Verdefluox/Eurocard_LNA/LNA_v1.pdf

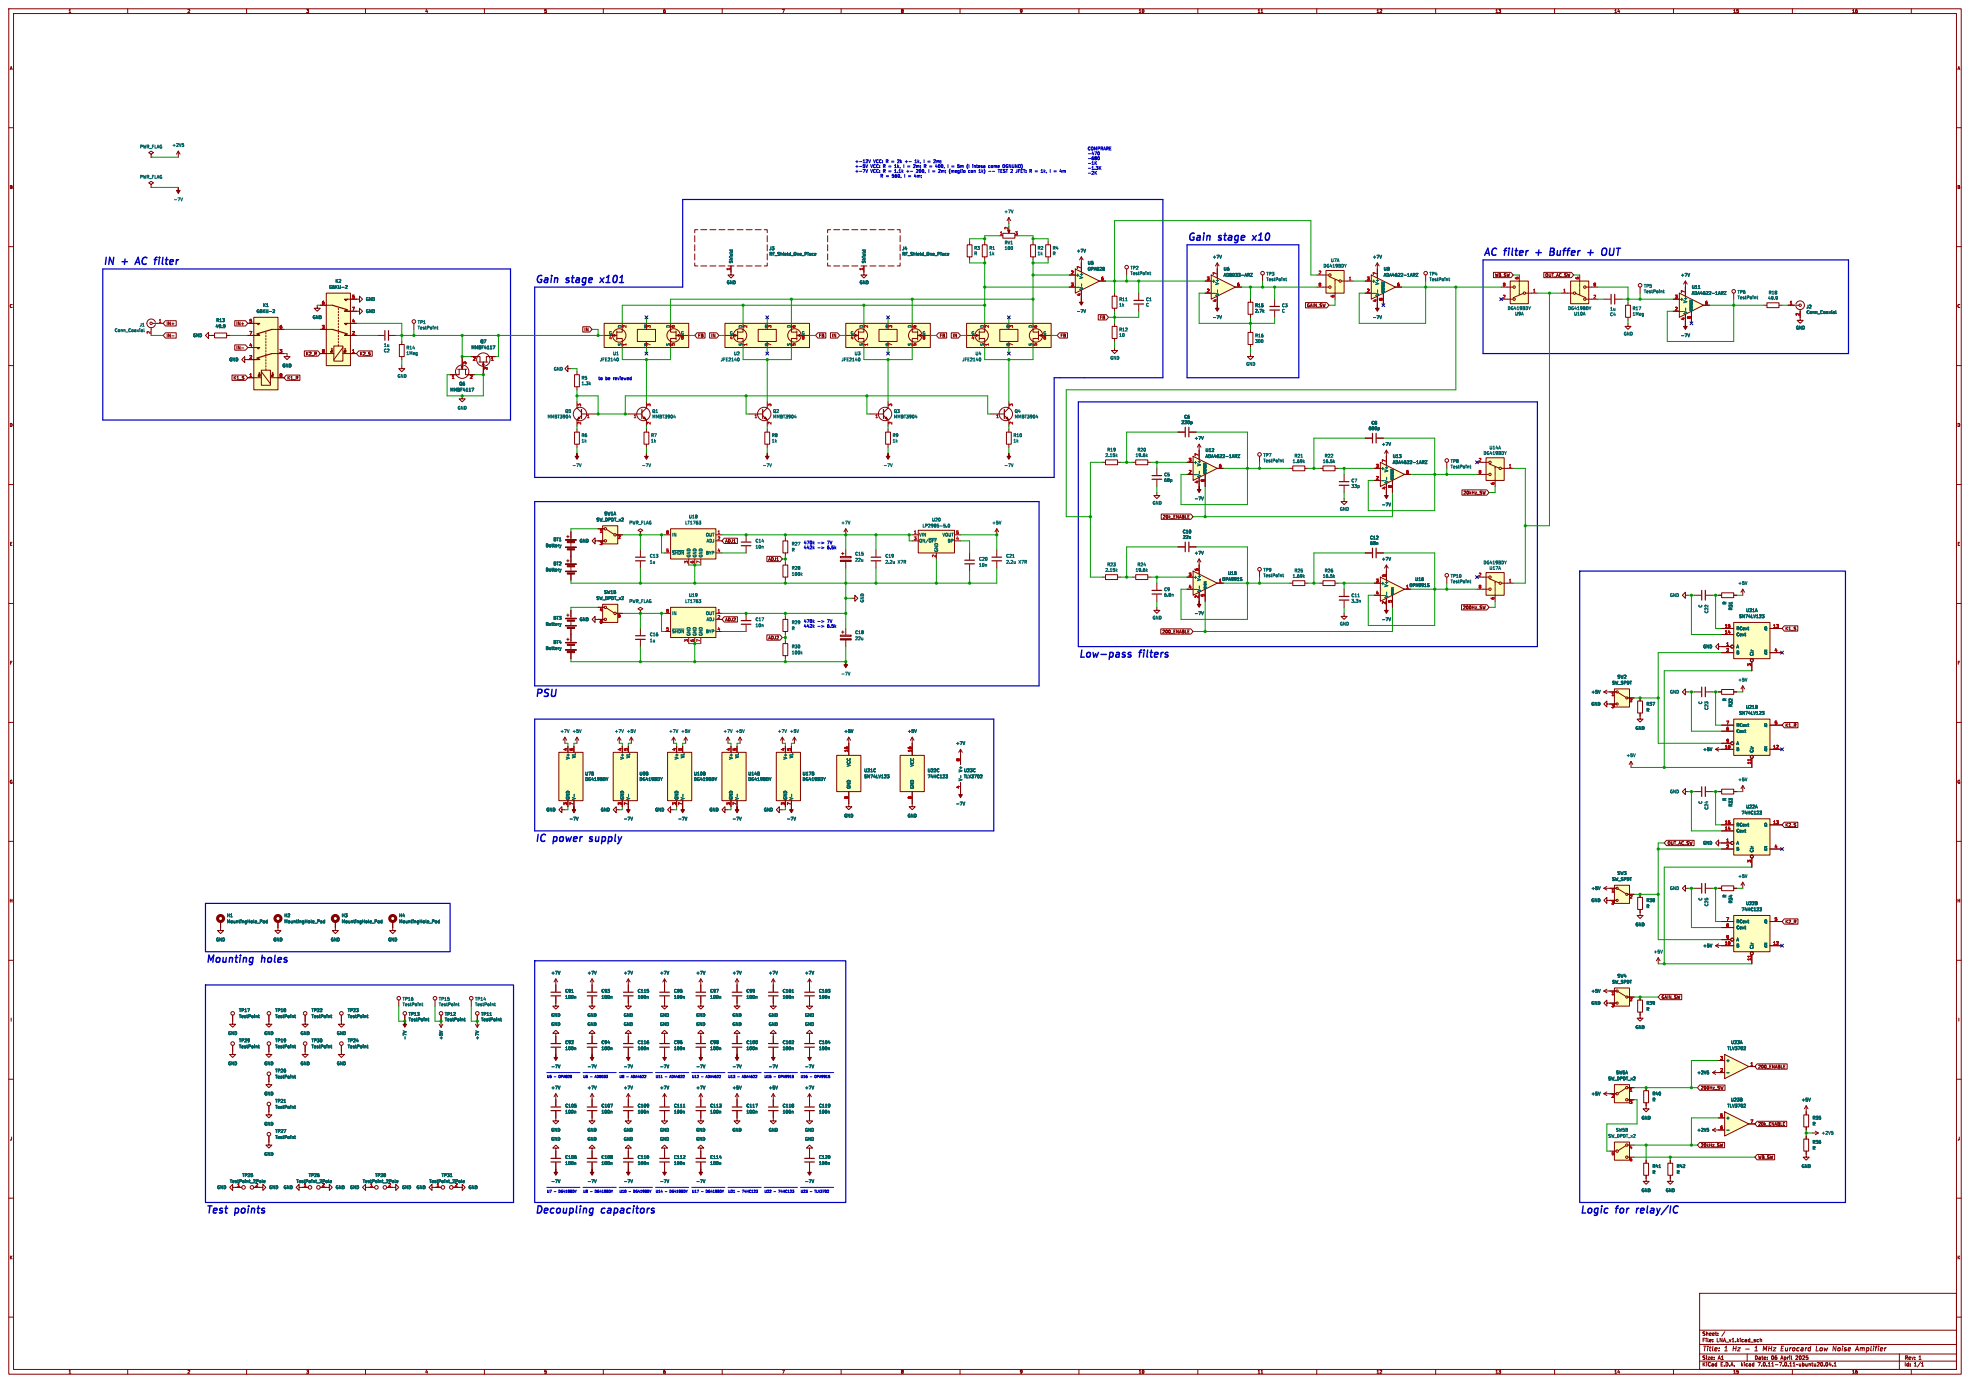
[picture p1: page 1]

AC filter + Buffer + OUT

Logic for relay/IC

Id: 1/1 Title: 1 Hz - 1 MHz Eurocard Low Noise Amplifier File: LNA_v1.kicad_sch Sheet: /
