Verdefluox/Eurocard_LNA/LNA_v1.kicad_pcb

## KiCad design LNA_v1.kicad_pcb (2025-04-08)

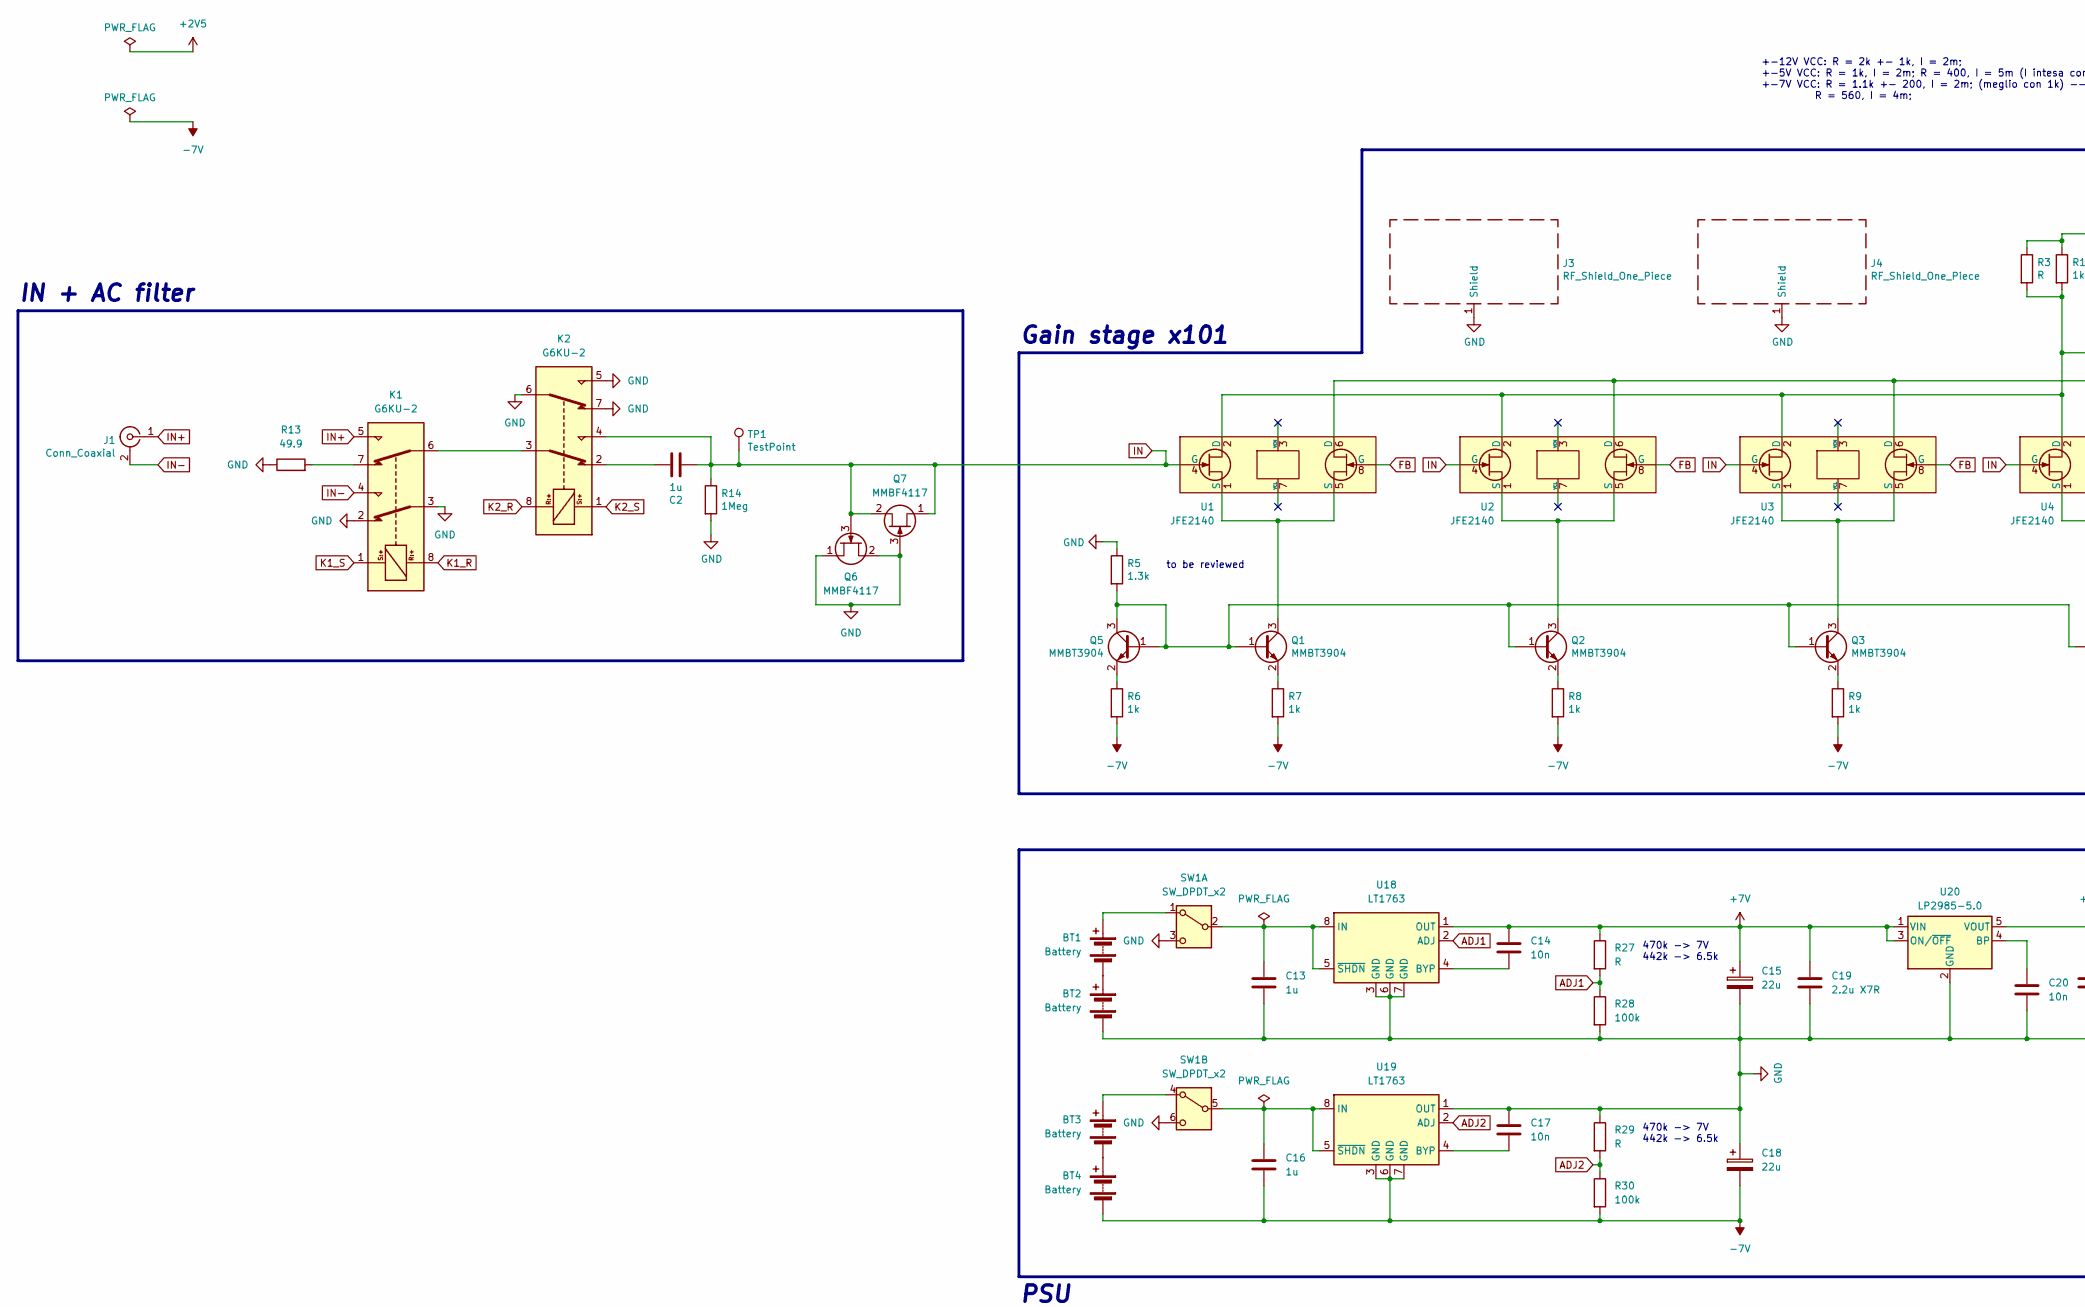
[picture p2: schematic LNA_v1.kicad_sch, 1 Hz - 1 MHz Eurocard Low Noise Amplifier, part in row 1, column 1]

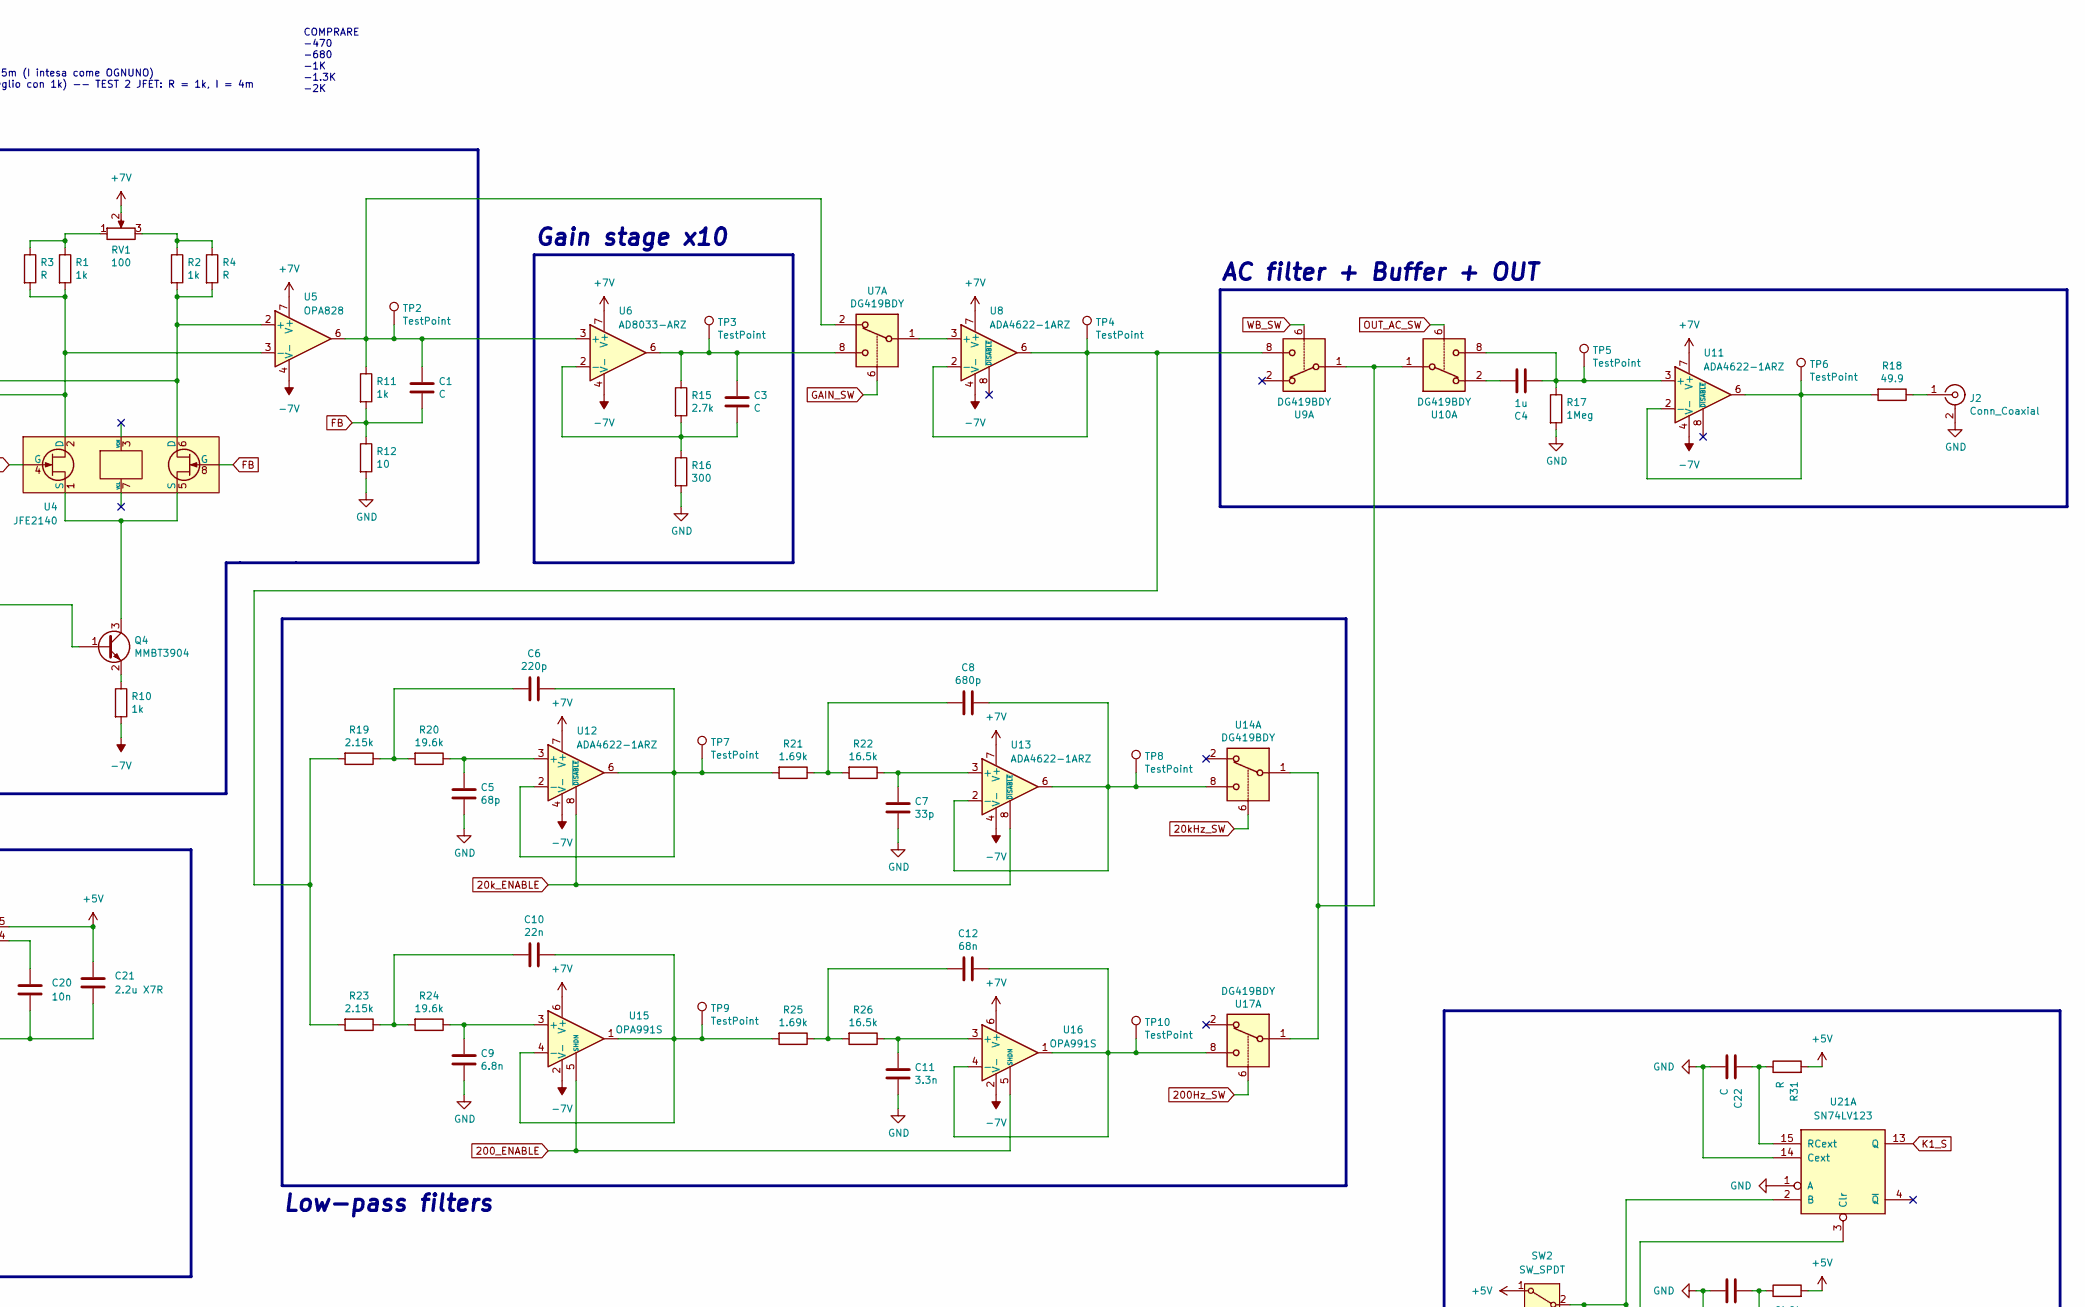
[picture p3: schematic LNA_v1.kicad_sch, 1 Hz - 1 MHz Eurocard Low Noise Amplifier, part in row 1, column 2]

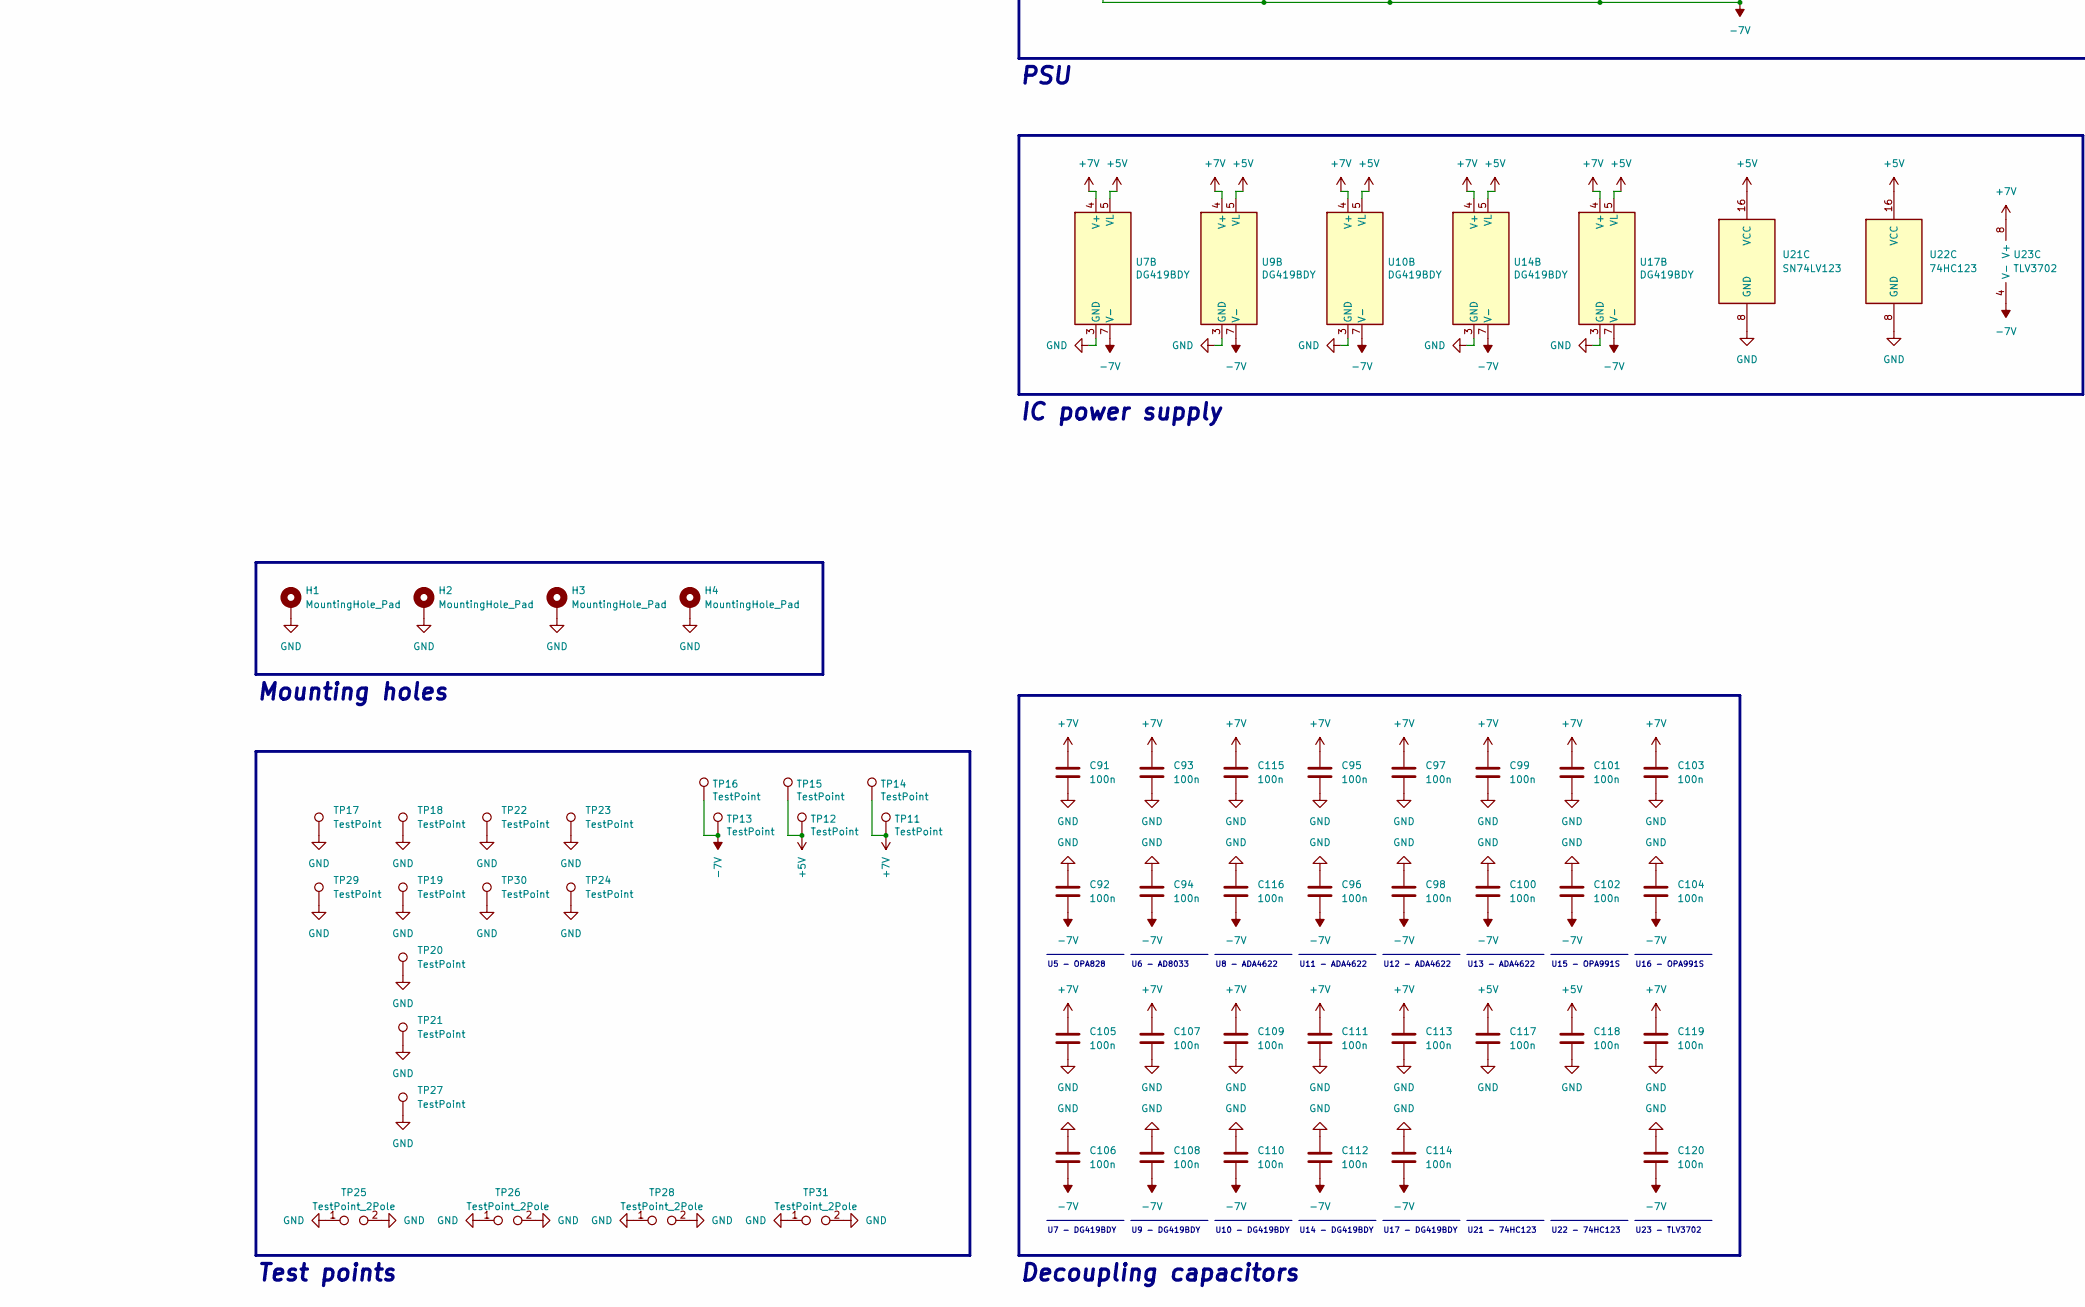
[picture p4: schematic LNA_v1.kicad_sch, 1 Hz - 1 MHz Eurocard Low Noise Amplifier, part in row 2, column 1]

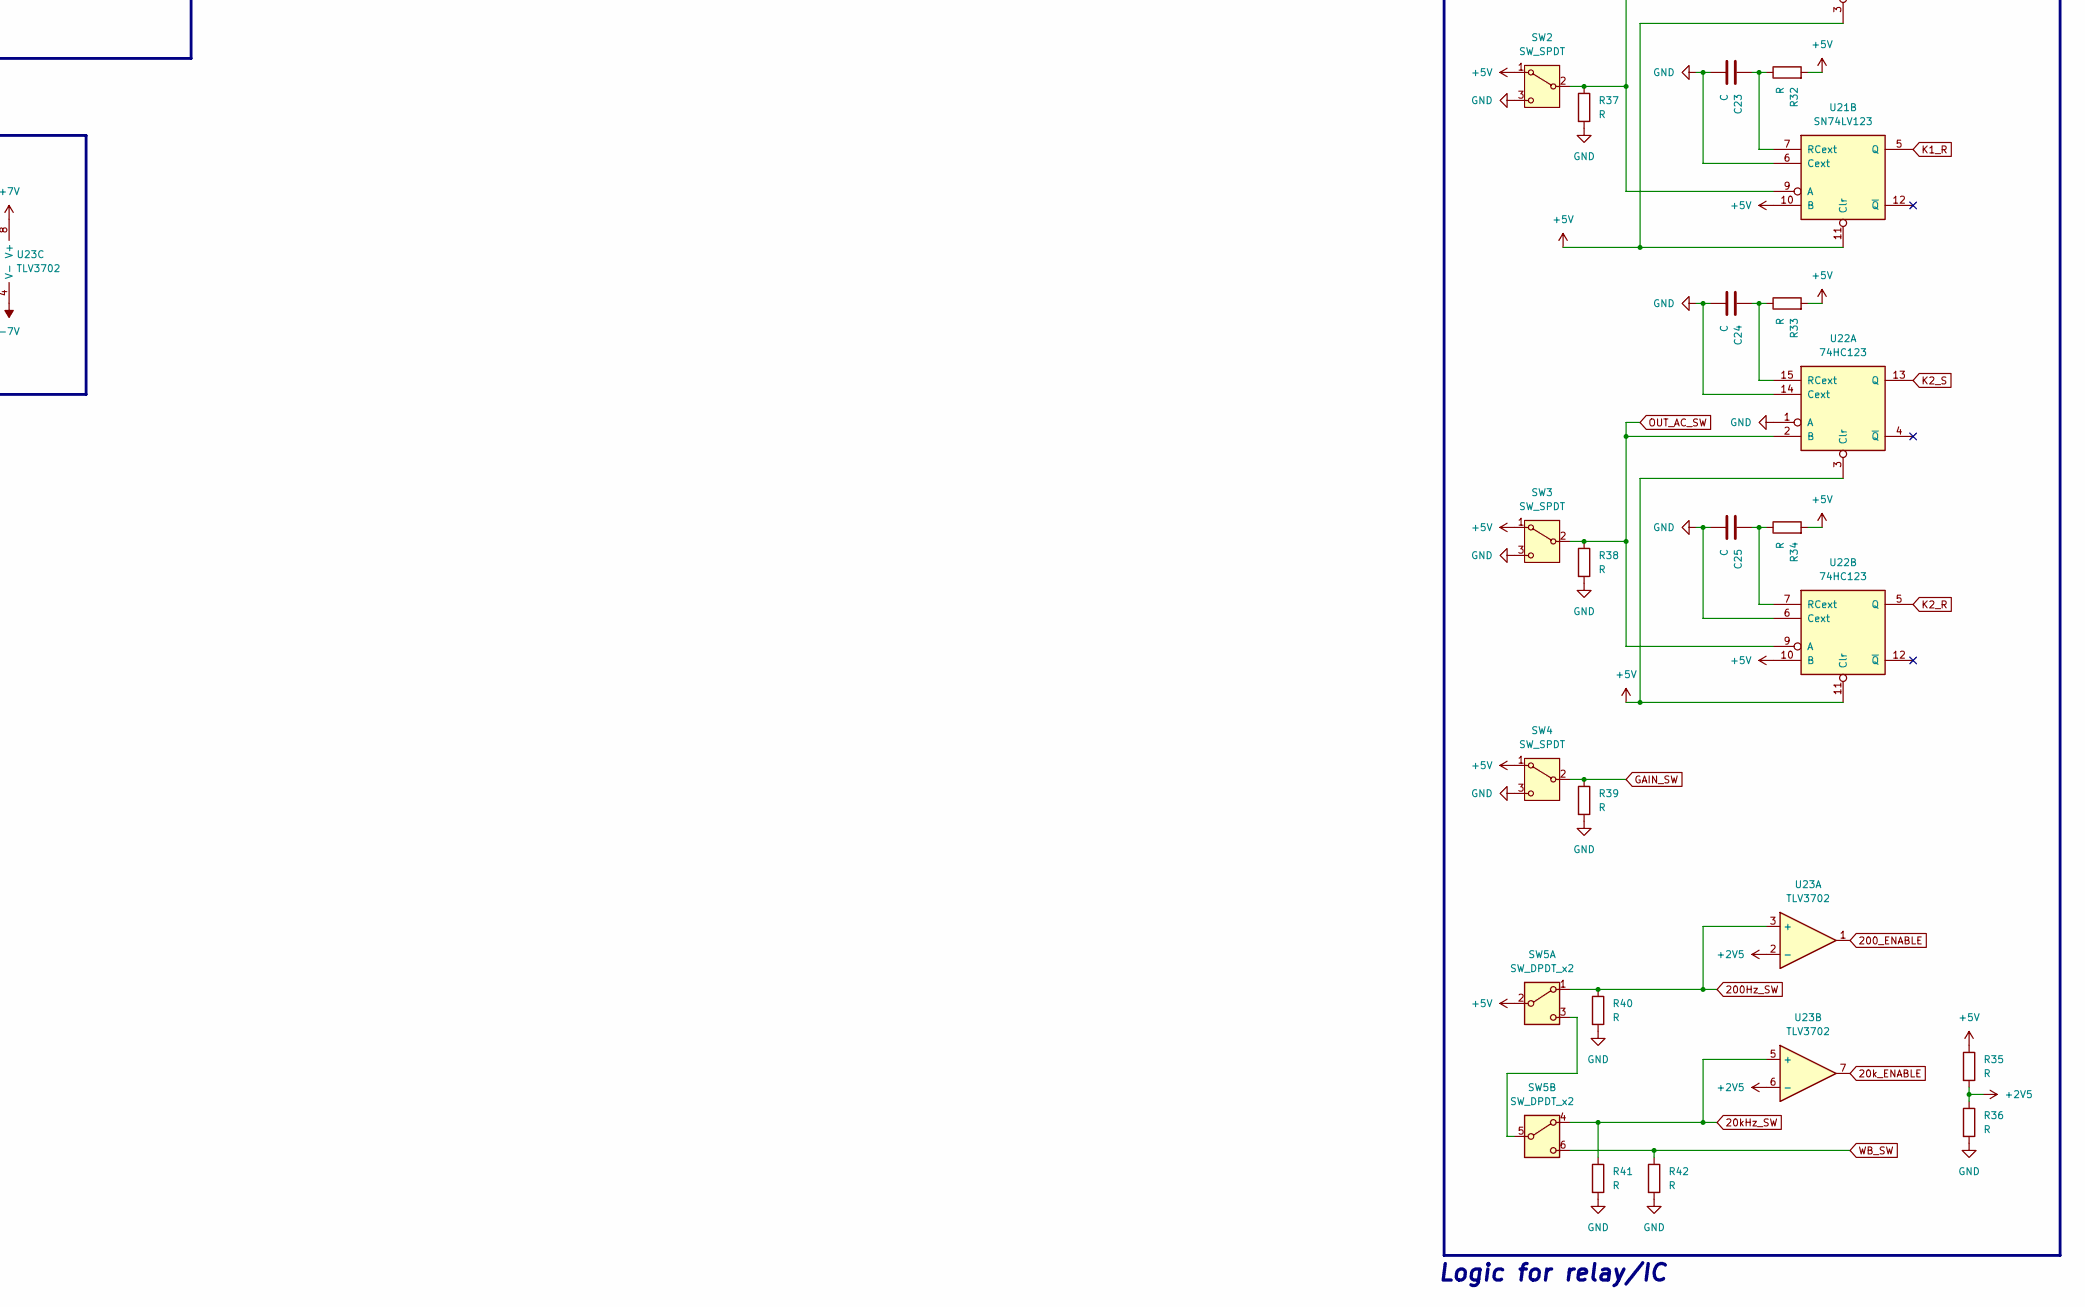
[picture p5: schematic LNA_v1.kicad_sch, 1 Hz - 1 MHz Eurocard Low Noise Amplifier, part in row 2, column 2]

Parts:
BT1, BT2, BT3, BT4: Battery; 14500_Keystone53
C1, C3: C; C_0805_2012Metric_Pad1.18x1.45mm_HandSolder
C2, C4: 1u; C_Rect_L16.5mm_W7.3mm_P15.00mm_MKT
C5: 68p; C_1206_3216Metric_Pad1.33x1.80mm_HandSolder
C6: 220p; C_1206_3216Metric_Pad1.33x1.80mm_HandSolder
C7: 33p; C_1206_3216Metric_Pad1.33x1.80mm_HandSolder
C8: 680p; C_1206_3216Metric_Pad1.33x1.80mm_HandSolder
C9: 6.8n; C_1206_3216Metric_Pad1.33x1.80mm_HandSolder
C10: 22n; C_1206_3216Metric_Pad1.33x1.80mm_HandSolder
C11: 3.3n; C_1206_3216Metric_Pad1.33x1.80mm_HandSolder
C12: 68n; C_1206_3216Metric_Pad1.33x1.80mm_HandSolder
C13, C16: 1u; C_1206_3216Metric_Pad1.33x1.80mm_HandSolder
C14, C17: 10n; C_0805_2012Metric_Pad1.18x1.45mm_HandSolder
C15, C18: 22u; CP_EIA-3528-21_Kemet-B_Pad1.50x2.35mm_HandSolder
C19, C21: 2.2u X7R; C_1206_3216Metric_Pad1.33x1.80mm_HandSolder
C20: 10n; C_1206_3216Metric_Pad1.33x1.80mm_HandSolder
C22, C23, C24, C25: C; C_1206_3216Metric_Pad1.33x1.80mm_HandSolder
C91, C92, C93, C94, C95, C96, C97, C98, C99, C100, C101, C102, C103, C104, C105, C106, C107, C108, C109, C110, C111, C112, C113, C114, C115, C116, C117, C118, C119, C120: 100n; C_1206_3216Metric_Pad1.33x1.80mm_HandSolder
H1, H2, H3, H4: MountingHole_Pad; MountingHole_2.2mm_M2_Pad_Via
J1, J2: Conn_Coaxial; BNC_Amphenol_B6252HB-NPP3G-50_Horizontal
J3, J4: RF_Shield_One_Piece; Wuerth_36103305_30x30mm
K1, K2: G6KU-2; Relay_DPDT_Omron_G6K-2F-Y
Q1, Q2, Q3, Q4, Q5: MMBT3904; SOT-23W
Q6, Q7: MMBF4117; SOT-23
R1, R2, R6, R7, R8, R9, R10, R11: 1k; R_1206_3216Metric_Pad1.30x1.75mm_HandSolder
R3, R4, R31, R32, R33, R34, R35, R36, R37, R38, R39, R40, R41, R42: R; R_1206_3216Metric_Pad1.30x1.75mm_HandSolder
R5: 1.3k; R_1206_3216Metric_Pad1.30x1.75mm_HandSolder
R12: 10; R_1206_3216Metric_Pad1.30x1.75mm_HandSolder
R13, R18: 49.9; R_1206_3216Metric_Pad1.30x1.75mm_HandSolder
R14, R17: 1Meg; R_1206_3216Metric_Pad1.30x1.75mm_HandSolder
R15: 2.7k; R_1206_3216Metric_Pad1.30x1.75mm_HandSolder
R16: 300; R_1206_3216Metric_Pad1.30x1.75mm_HandSolder
R19, R23: 2.15k; R_1206_3216Metric_Pad1.30x1.75mm_HandSolder
R20, R24: 19.6k; R_1206_3216Metric_Pad1.30x1.75mm_HandSolder
R21, R25: 1.69k; R_1206_3216Metric_Pad1.30x1.75mm_HandSolder
R22, R26: 16.5k; R_1206_3216Metric_Pad1.30x1.75mm_HandSolder
R27, R29: R; R_0805_2012Metric_Pad1.20x1.40mm_HandSolder
R28, R30: 100k; R_0805_2012Metric_Pad1.20x1.40mm_HandSolder
RV1: 100; Potentiometer_Bourns_3296W_Vertical
SW1, SW5: SW_DPDT_x2; 100DPXTXBXMXXX
SW2, SW3, SW4: SW_SPDT; 100AWSPXTXBXMXXX
TP1: TestPoint; TestPoint_Pad_D1.5mm
TP2, TP3, TP4, TP5, TP6, TP7, TP8, TP9, TP10, TP11, TP12, TP13, TP14, TP15, TP16: TestPoint; TestPoint_Pad_D1.0mm
TP17, TP18, TP19, TP20, TP21, TP22, TP23, TP24, TP27, TP29, TP30: TestPoint; TestPoint_THTPad_D1.0mm_Drill0.5mm
TP25, TP26, TP28, TP31: TestPoint_2Pole; TestPoint_2Pads_Pitch5.08mm_Drill1.3mm
U1, U2, U3, U4: JFE2140; SOIC-8_3.9x4.9mm_P1.27mm
U5: OPA828; SOIC-8_3.9x4.9mm_P1.27mm
U6: AD8033-ARZ; SOIC-8_3.9x4.9mm_P1.27mm
U7, U9, U10, U14, U17: DG419BDY; SOIC-8_3.9x4.9mm_P1.27mm
U8, U11, U12, U13: ADA4622-1ARZ; SOIC-8_3.9x4.9mm_P1.27mm
U15, U16: OPA991S; SOT-23-6
U18, U19: LT1763; SOIC-8_3.9x4.9mm_P1.27mm
U20: LP2985-5.0; SOT-23-5
U21: SN74LV123; SOIC-16_3.9x9.9mm_P1.27mm
U22: 74HC123; SOIC-16_3.9x9.9mm_P1.27mm
U23: TLV3702; SOIC-8_3.9x4.9mm_P1.27mm

Connections:
20kHz_SW: R41.1, SW5.4 (A), U14.6, U23.5 (+)
20k_ENABLE: U12.8 (~DISABLE), U13.8 (~DISABLE), U23.7
200Hz_SW: R40.1, SW5.1 (A), U17.6, U23.3 (+)
200_ENABLE: U15.5 (SHDN), U16.5 (SHDN), U23.1
+2V5: R35.2, R36.1, U23.2 (-), U23.6 (-)
+5V: C21.1, C117.1, C118.1, R31.2, R32.2, R33.2, R34.2, R35.1, SW2.1 (A), SW3.1 (A), SW4.1 (A), SW5.2 (B), TP12.1, TP15.1, U7.5 (VL), U9.5 (VL), U10.5 (VL), U14.5 (VL), U17.5 (VL), U20.5 (VOUT), U21.3 (Clr), U21.10 (B), U21.11 (Clr), U21.16 (VCC), U22.3 (Clr), U22.10 (B), U22.11 (Clr), U22.16 (VCC)
+7V: C14.1, C15.1, C19.1, C91.1, C93.1, C95.1, C97.1, C99.1, C101.1, C103.1, C105.1, C107.1, C109.1, C111.1, C113.1, C115.1, C119.1, R27.1, RV1.2, TP11.1, TP14.1, U5.7 (V+), U6.7 (V+), U7.4 (V+), U8.7 (V+), U9.4 (V+), U10.4 (V+), U11.7 (V+), U12.7 (V+), U13.7 (V+), U14.4 (V+), U15.6 (V+), U16.6 (V+), U17.4 (V+), U18.1 (OUT), U20.1 (VIN), U20.3 (ON/~OFF), U23.8 (V+)
-7V: BT4.2 (-), C16.2, C18.2, C92.2, C94.2, C96.2, C98.2, C100.2, C102.2, C104.2, C106.2, C108.2, C110.2, C112.2, C114.2, C116.2, C120.2, R6.2, R7.2, R8.2, R9.2, R10.2, R30.2, TP13.1, TP16.1, U5.4 (V-), U6.4 (V-), U7.7 (V-), U8.4 (V-), U9.7 (V-), U10.7 (V-), U11.4 (V-), U12.4 (V-), U13.4 (V-), U14.7 (V-), U15.2 (V-), U16.2 (V-), U17.7 (V-), U19.3 (GND), U19.6 (GND), U19.7 (GND), U23.4 (V-)
ADJ1: R27.2, R28.1, U18.2 (ADJ)
ADJ2: R29.2, R30.1, U19.2 (ADJ)
FB: C1.2, R11.2, R12.1, U1.8 (G), U2.8 (G), U3.8 (G), U4.8 (G)
GAIN_SW: R39.1, SW4.2 (B), U7.6
GND: BT2.2 (-), C5.1, C7.1, C9.1, C11.1, C13.2, C15.2, C17.1, C18.1, C19.2, C20.2, C21.2, C22.2, C23.2, C24.2, C25.2, C91.2, C92.1, C93.2, C94.1, C95.2, C96.1, C97.2, C98.1, C99.2, C100.1, C101.2, C102.1, C103.2, C104.1, C105.2, C106.1, C107.2, C108.1, C109.2, C110.1, C111.2, C112.1, C113.2, C114.1, C115.2, C116.1, C117.2, C118.2, C119.2, C120.1, H1.1, H2.1, H3.1, H4.1, J2.2 (Ext), J3.1 (Shield), J4.1 (Shield), K1.2, K1.3, K2.5, K2.6, K2.7, Q6.1 (S), Q6.2 (D), Q7.3 (G), R5.1, R12.2, R13.1, R14.2, R16.2, R17.2, R28.2, R29.1, R36.2, R37.2, R38.2, R39.2, R40.2, R41.2, R42.2, SW1.3 (C), SW1.6 (C), SW2.3 (C), SW3.3 (C), SW4.3 (C), TP17.1, TP18.1, TP19.1, TP20.1, TP21.1, TP22.1, TP23.1, TP24.1, TP25.1, TP25.2, TP26.1, TP26.2, TP27.1, TP28.1, TP28.2, TP29.1, TP30.1, TP31.1, TP31.2, U7.3 (GND), U9.3 (GND), U10.3 (GND), U14.3 (GND), U17.3 (GND), U18.3 (GND), U18.6 (GND), U18.7 (GND), U19.1 (OUT), U20.2 (GND), U21.1 (A), U21.6 (Cext), U21.8 (GND), U21.14 (Cext), U22.1 (A), U22.6 (Cext), U22.8 (GND), U22.14 (Cext)
IN: C2.1, K2.4, Q6.3 (G), Q7.1 (S), Q7.2 (D), R14.1, TP1.1, U1.4 (G), U2.4 (G), U3.4 (G), U4.4 (G)
IN+: J1.1 (In), K1.5
IN-: J1.2 (Ext), K1.4
K1_R: K1.8, U21.5 (Q)
K1_S: K1.1, U21.13 (Q)
K2_R: K2.8, U22.5 (Q)
K2_S: K2.1, U22.13 (Q)
unnamed: BT1.1 (+), SW1.1 (A)
unnamed: BT1.2 (-), BT2.1 (+)
unnamed: BT3.1 (+), SW1.4 (A)
unnamed: BT3.2 (-), BT4.1 (+)
unnamed: C2.2, K2.2
unnamed: C3.1, R15.1, TP3.1, U6.6, U7.8
unnamed: C4.2, U10.2
unnamed: C6.2, R19.1, R20.2
unnamed: C8.2, R21.1, R22.2
unnamed: C10.2, R23.1, R24.2
unnamed: C12.2, R25.1, R26.2
unnamed: J2.1 (In), R18.1
unnamed: K1.6, K2.3
unnamed: K1.7, R13.2
unnamed: Q1.1 (B), Q2.1 (B), Q3.1 (B), Q4.1 (B), Q5.1 (B), Q5.3 (C), R5.2
unnamed: Q1.3 (C), U1.1 (S), U1.5 (S)
unnamed: Q1.2 (E), R7.1
unnamed: Q2.3 (C), U2.1 (S), U2.5 (S)
unnamed: Q2.2 (E), R8.1
unnamed: Q3.3 (C), U3.1 (S), U3.5 (S)
unnamed: Q3.2 (E), R9.1
unnamed: Q4.3 (C), U4.1 (S), U4.5 (S)
unnamed: Q4.2 (E), R10.1
unnamed: Q5.2 (E), R6.1
unnamed: R1.1, R3.1, RV1.1
unnamed: R2.1, R4.1, RV1.3
unnamed: C13.1, SW1.2 (B), U18.5 (~SHDN), U18.8 (IN)
unnamed: C16.1, SW1.5 (B), U19.5 (~SHDN), U19.8 (IN)
unnamed: R37.1, SW2.2 (B), U21.2 (B), U21.9 (A)
unnamed: SW5.3 (C), SW5.5 (B)
unnamed: R2.2, R4.2, U1.6 (D), U2.6 (D), U3.6 (D), U4.6 (D), U5.2 (+)
unnamed: R1.2, R3.2, U1.2 (D), U2.2 (D), U3.2 (D), U4.2 (D), U5.3 (-)
unnamed: C1.1, R11.1, TP2.1, U5.6, U6.3 (+), U7.2
unnamed: C3.2, R15.2, R16.1, U6.2 (-)
unnamed: U7.1, U8.3 (+)
unnamed: R19.2, R23.2, TP4.1, U8.2 (-), U8.6, U9.8
unnamed: U9.1, U10.1, U14.1, U17.1
unnamed: C4.1, R17.1, TP5.1, U10.8, U11.3 (+)
unnamed: R18.2, TP6.1, U11.2 (-), U11.6
unnamed: C5.2, R20.1, U12.3 (+)
unnamed: C6.1, R21.2, TP7.1, U12.2 (-), U12.6
unnamed: C7.2, R22.1, U13.3 (+)
unnamed: C8.1, TP8.1, U13.2 (-), U13.6, U14.8
unnamed: C9.2, R24.1, U15.3 (+)
unnamed: C10.1, R25.2, TP9.1, U15.1, U15.4 (-)
unnamed: C11.2, R26.1, U16.3 (+)
unnamed: C12.1, TP10.1, U16.1, U16.4 (-), U17.8
unnamed: C14.2, U18.4 (BYP)
unnamed: C17.2, U19.4 (BYP)
unnamed: C20.1, U20.4 (BP)
unnamed: C22.1, R31.1, U21.15 (RCext)
unnamed: C23.1, R32.1, U21.7 (RCext)
unnamed: C24.1, R33.1, U22.15 (RCext)
unnamed: C25.1, R34.1, U22.7 (RCext)
OUT_AC_SW: R38.1, SW3.2 (B), U10.6, U22.2 (B), U22.9 (A)
WB_SW: R42.1, SW5.6 (C), U9.6

Notes on the sheet:
U17 - DG419BDY
U21 - 74HC123
Logic for relay/IC
+-12V VCC: R = 2k +- 1k, I = 2m; +-5V VCC: R = 1k, I = 2m; R = 400, I = 5m (I intesa come OGNUNO) +-7V VCC: R = 1.1k +- 200, I = 2m; (meglio con 1k) -- TEST 2 JFET: R = 1k, I = 4m R = 560, I = 4m;
470k -> 7V 442k -> 6.5k
IN + AC filter
U6 - AD8033
U23 - TLV3702
Decoupling capacitors
U13 - ADA4622
U7 - DG419BDY
to be reviewed
U8 - ADA4622
U14 - DG419BDY
U16 - OPA991S
IC power supply
PSU
U5 - OPA828
Gain stage x101
U12 - ADA4622
AC filter + Buffer + OUT
Gain stage x10
U10 - DG419BDY
U15 - OPA991S
Low-pass filters
U22 - 74HC123
U9 - DG419BDY
COMPRARE -470 -680 -1K -1.3K -2K
Test points
Mounting holes
U11 - ADA4622

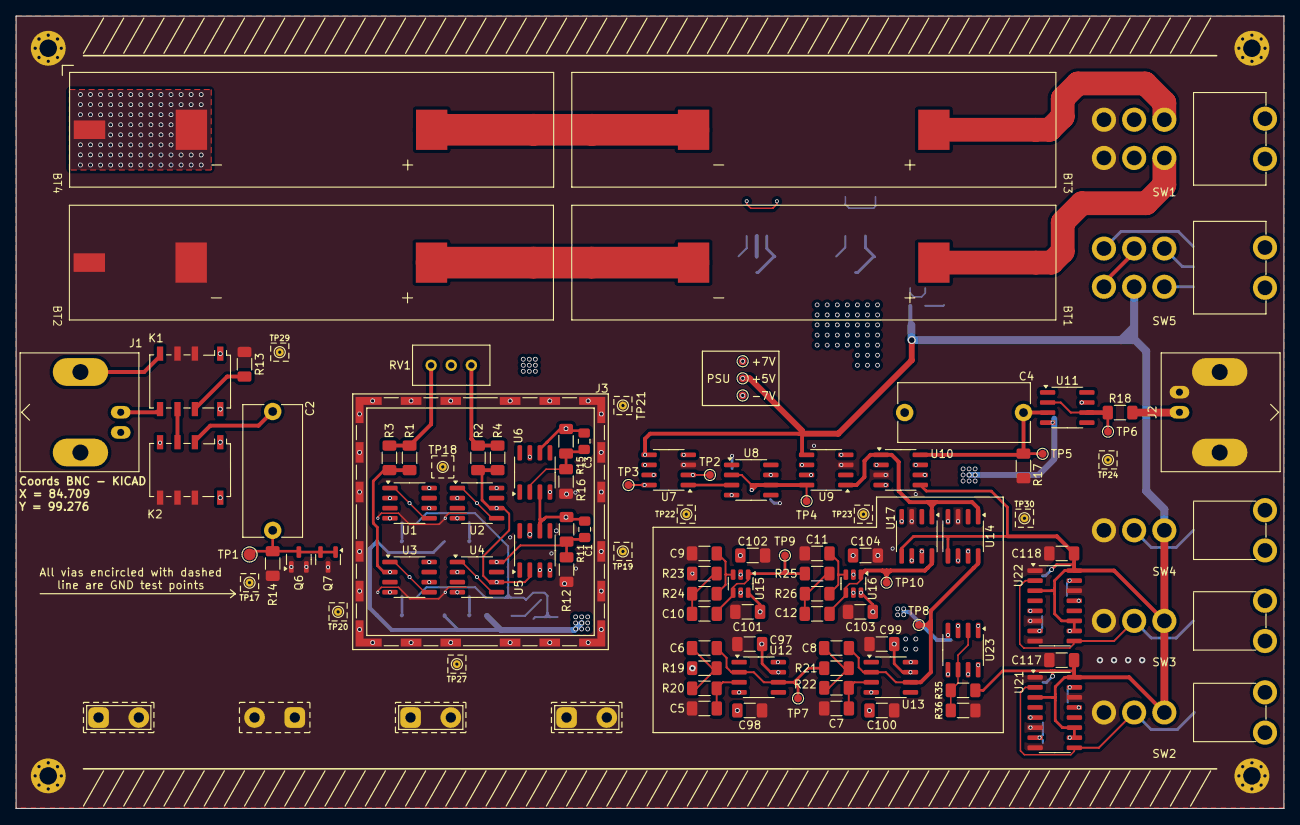
[picture p6: board LNA_v1.kicad_pcb from above]

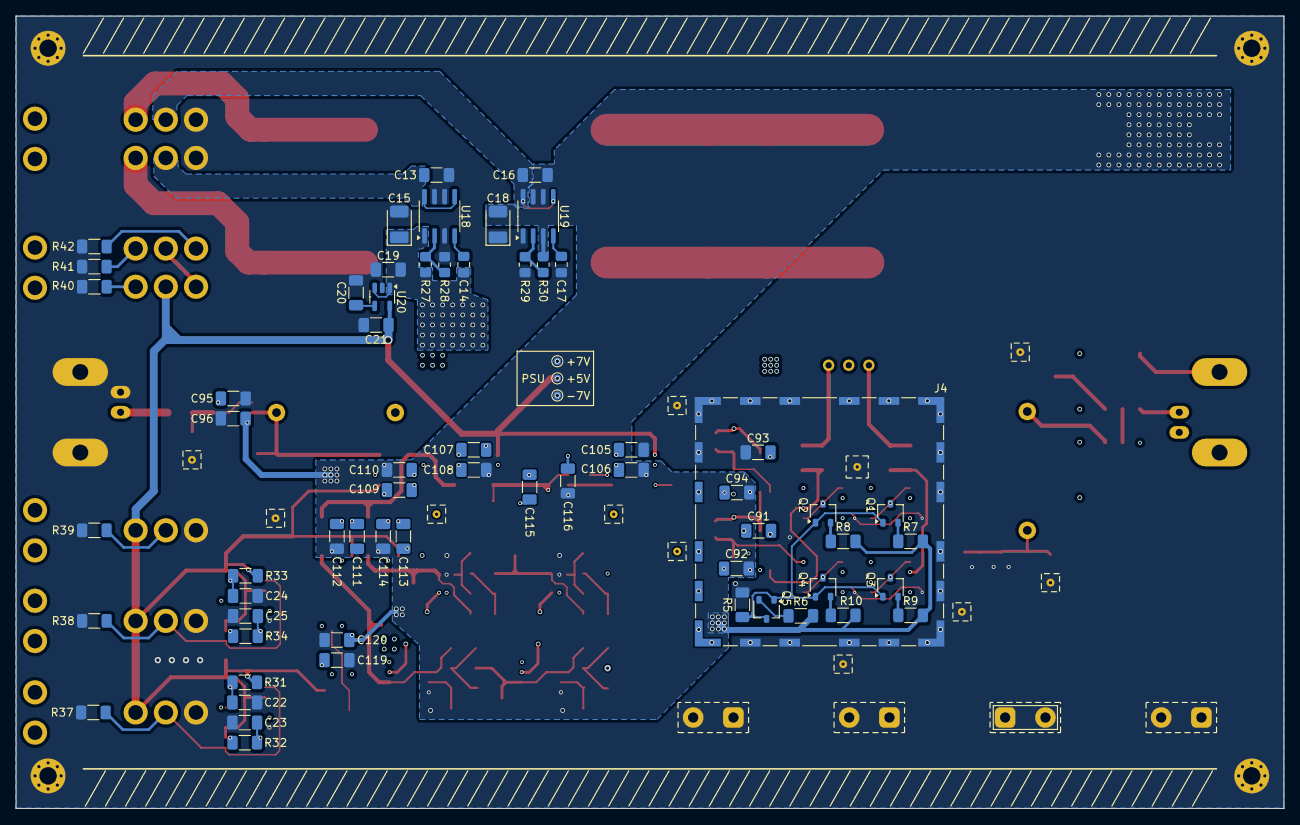
[picture p7: board LNA_v1.kicad_pcb from below]

Board: 4 copper layers, 160.0 x 100.0 mm, 178 parts (66 on the bottom side), 76 nets.
