Verdefluox/Eurocard_LNA/LNA_v1_BACKUP.kicad_pcb

## KiCad design LNA_v1_BACKUP.kicad_pcb (2025-08-28)

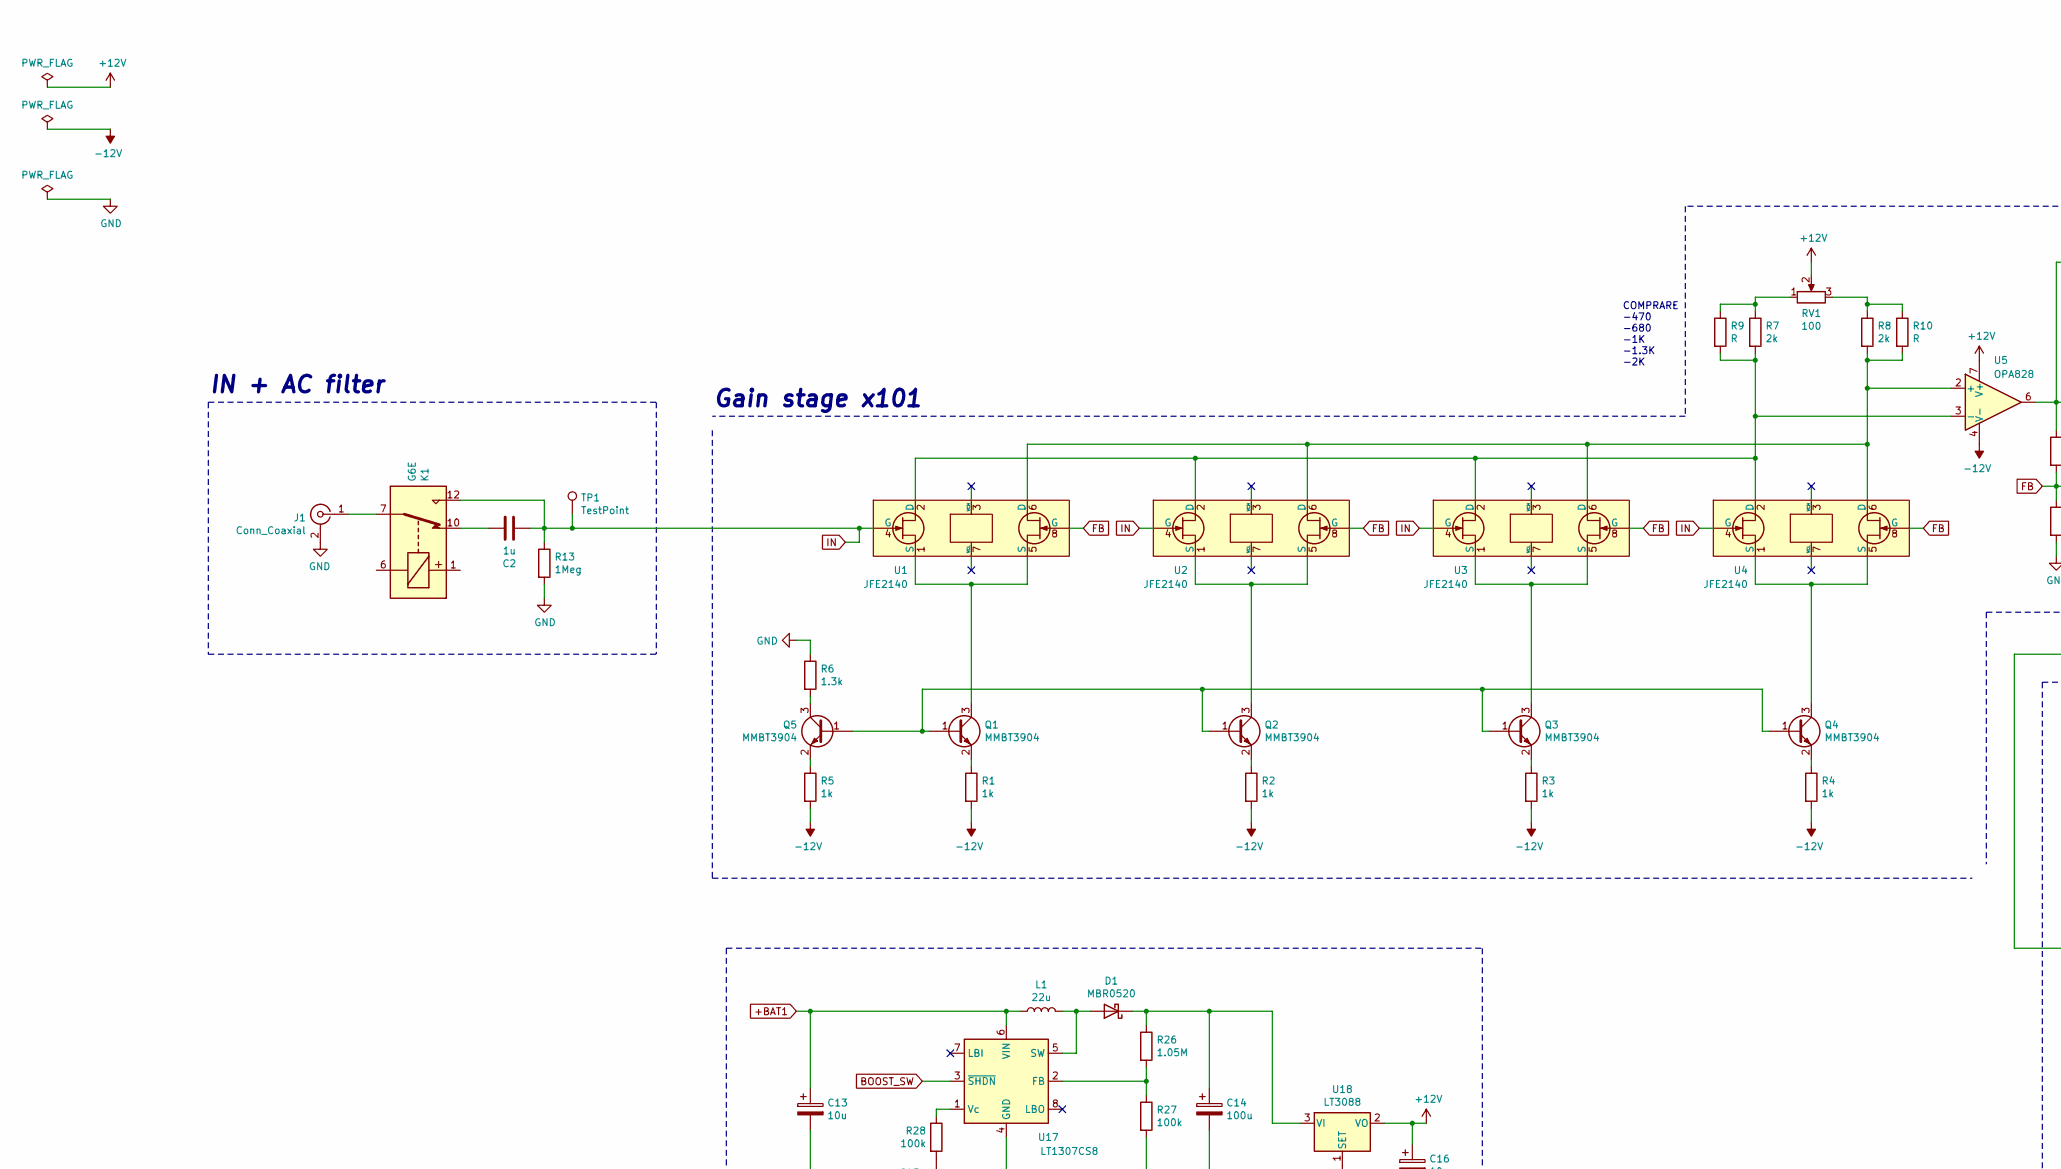
[picture p8: schematic LNA_v1.sch, part in row 1, column 1]

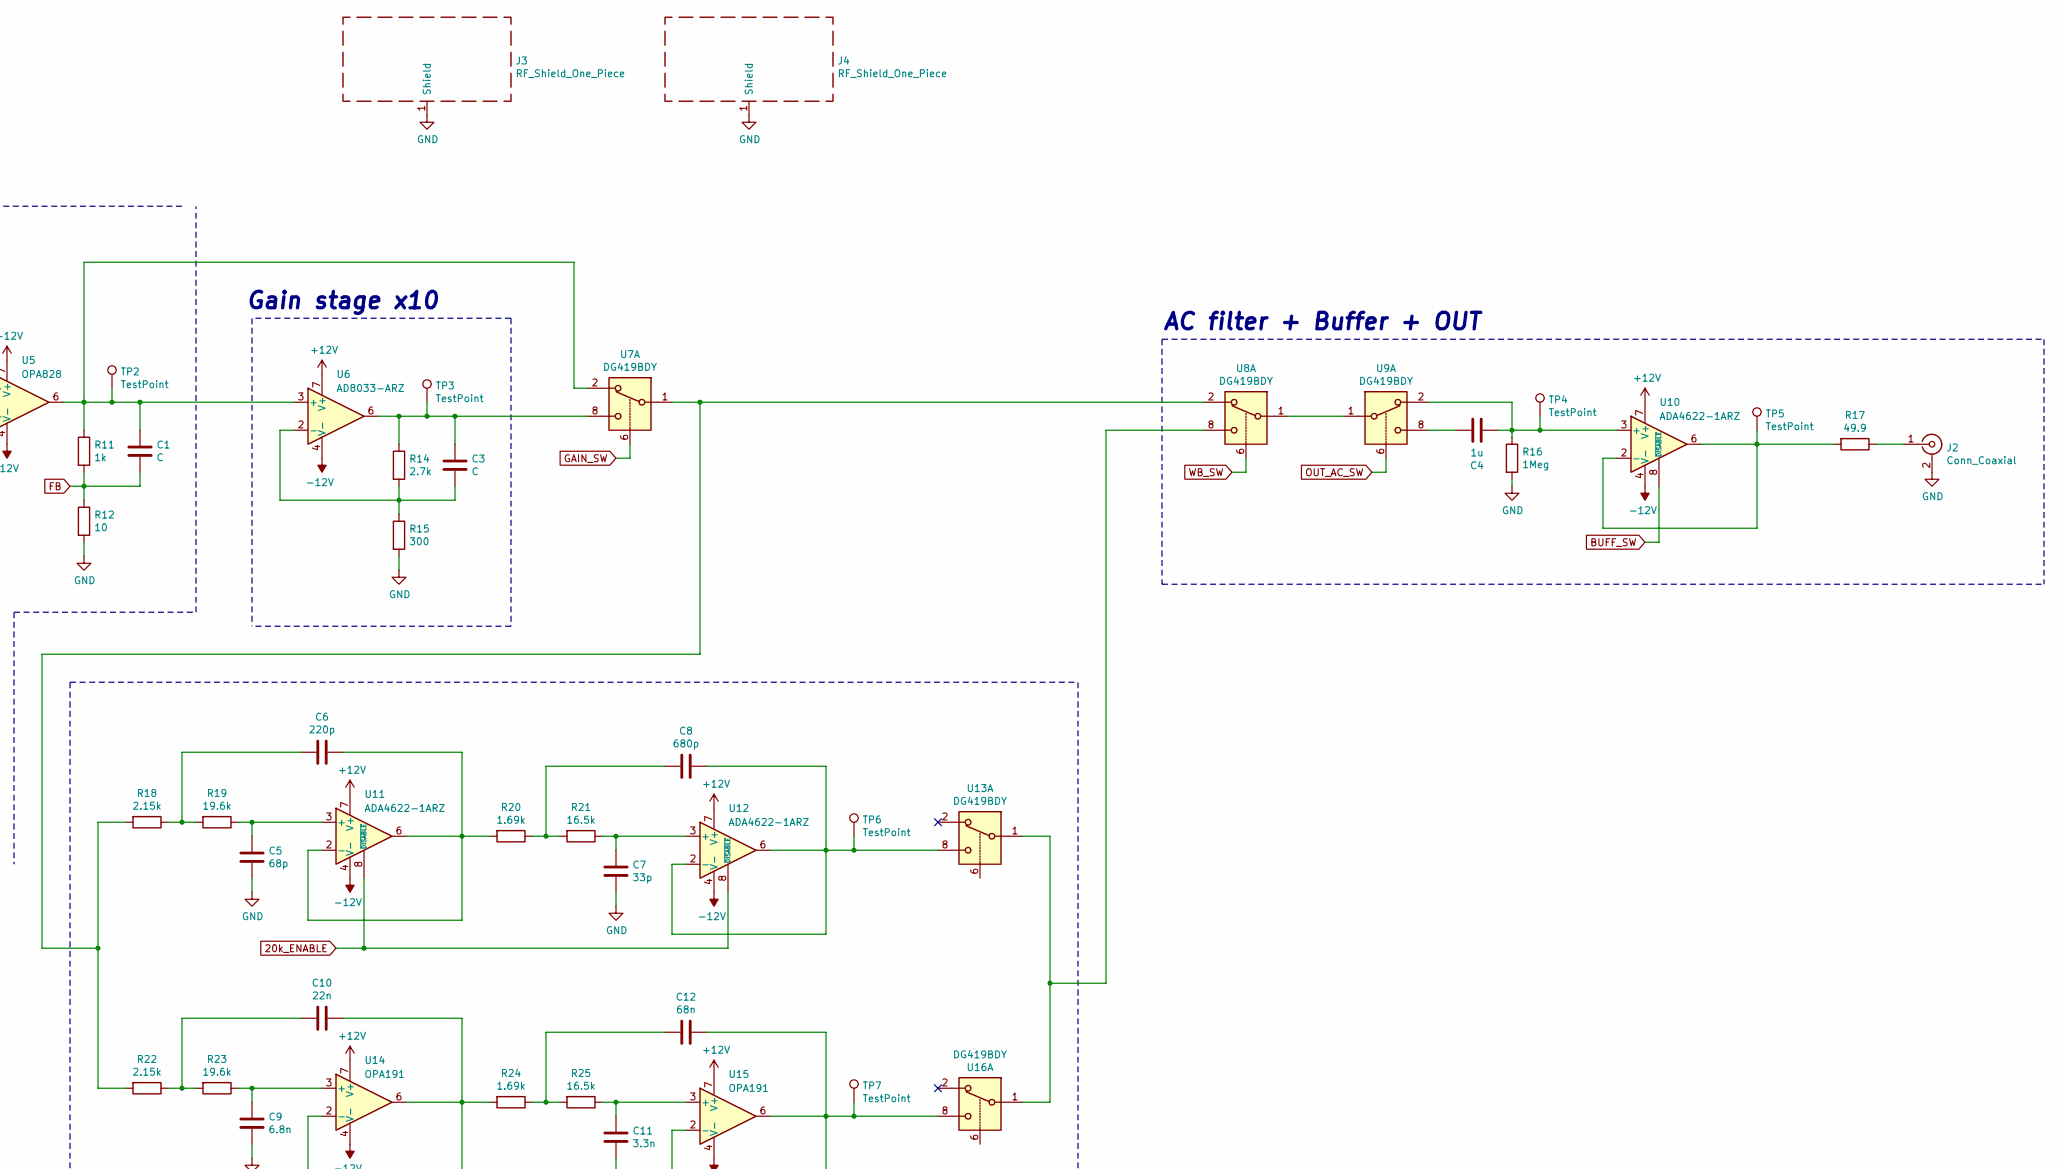
[picture p9: schematic LNA_v1.sch, part in row 1, column 2]

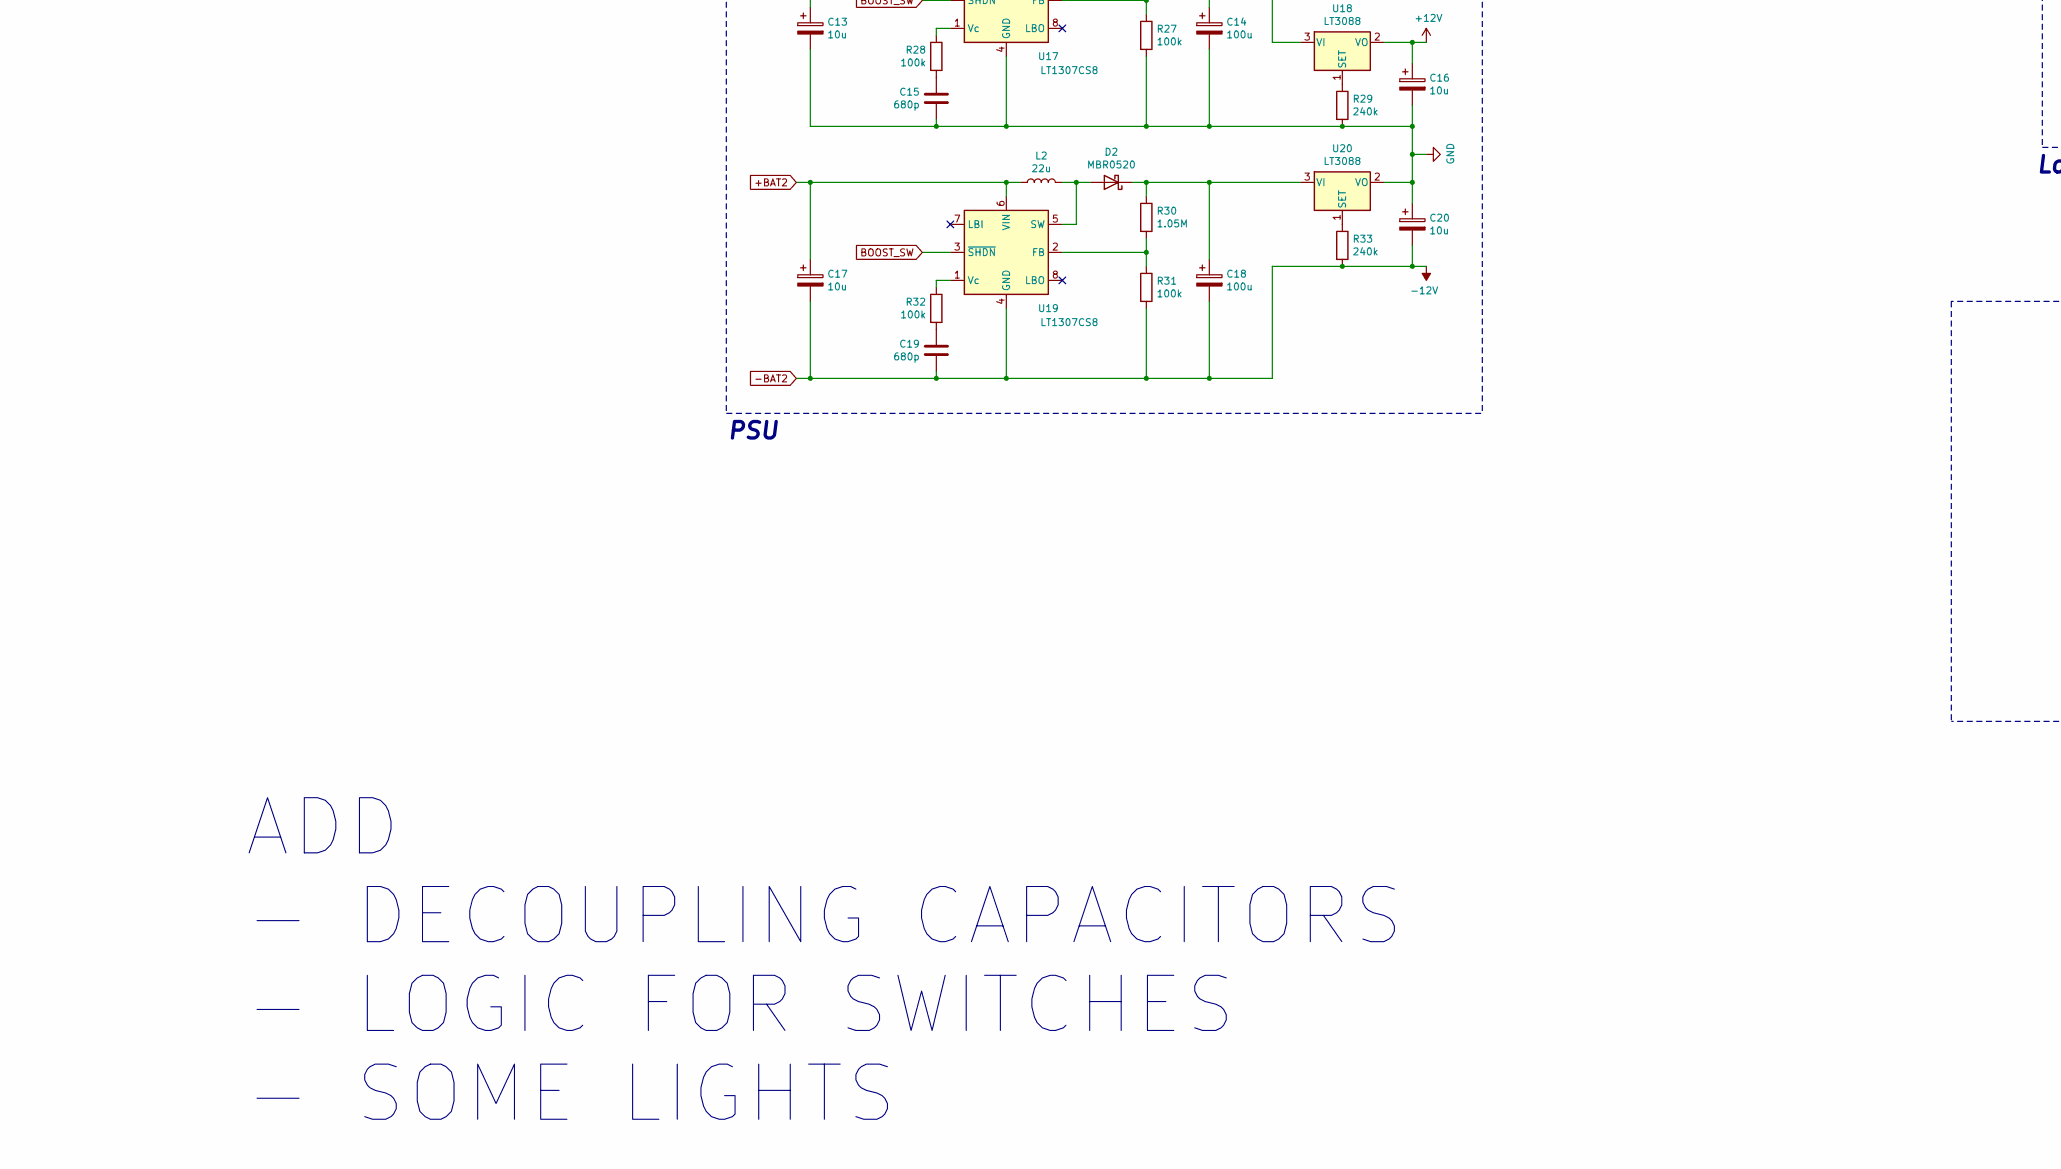
[picture p10: schematic LNA_v1.sch, part in row 2, column 1]

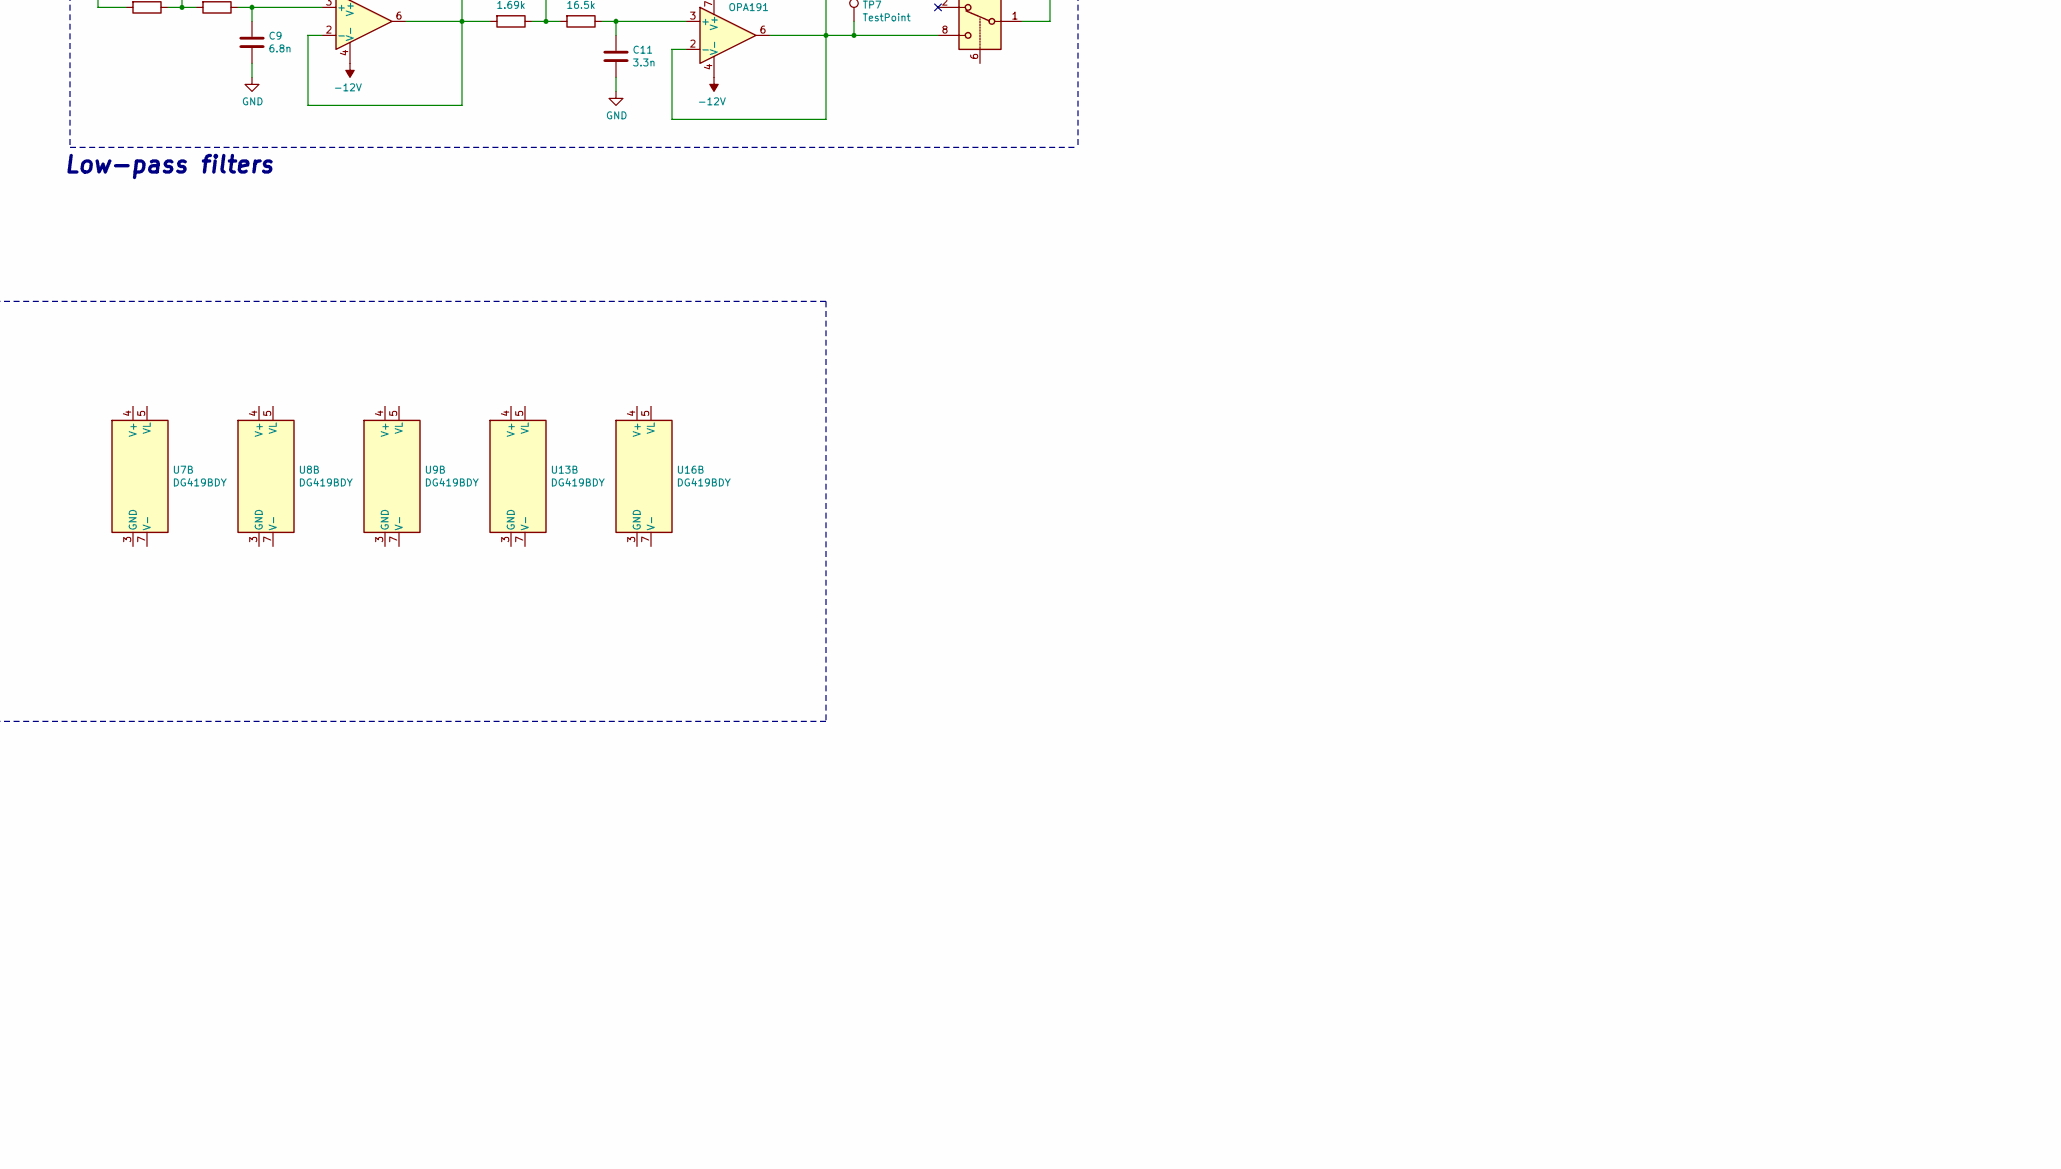
[picture p11: schematic LNA_v1.sch, part in row 2, column 2]

Parts:
C1, C3: C; C_1206_3216Metric_Pad1.33x1.80mm_HandSolder
C2, C4: 1u; C_Rect_L16.5mm_W7.3mm_P15.00mm_MKT
C5: 68p; C_1206_3216Metric_Pad1.33x1.80mm_HandSolder
C6: 220p; C_1206_3216Metric_Pad1.33x1.80mm_HandSolder
C7: 33p; C_1206_3216Metric_Pad1.33x1.80mm_HandSolder
C8, C15, C19: 680p; C_1206_3216Metric_Pad1.33x1.80mm_HandSolder
C9: 6.8n; C_1206_3216Metric_Pad1.33x1.80mm_HandSolder
C10: 22n; C_1206_3216Metric_Pad1.33x1.80mm_HandSolder
C11: 3.3n; C_1206_3216Metric_Pad1.33x1.80mm_HandSolder
C12: 68n; C_1206_3216Metric_Pad1.33x1.80mm_HandSolder
C13, C16, C17, C20: 10u; CP_Elec_6.3x5.8
C14, C18: 100u; CP_Elec_6.3x7.7
D1, D2: MBR0520; D_SOD-123
J1, J2: Conn_Coaxial; BNC_Amphenol_B6252HB-NPP3G-50_Horizontal
J3, J4: RF_Shield_One_Piece; Wuerth_36103255_25x25mm
K1: G6E; Relay_SPDT_Omron_G6E
L1, L2: 22u; L_Bourns-SRN1060
Q1, Q2, Q3, Q4, Q5: MMBT3904; SOT-23W
R1, R2, R3, R4, R5, R11: 1k; R_1206_3216Metric_Pad1.30x1.75mm_HandSolder
R6: 1.3k; R_1206_3216Metric_Pad1.30x1.75mm_HandSolder
R7, R8: 2k; R_1206_3216Metric_Pad1.30x1.75mm_HandSolder
R9, R10: R; R_1206_3216Metric_Pad1.30x1.75mm_HandSolder
R12: 10; R_1206_3216Metric_Pad1.30x1.75mm_HandSolder
R13, R16: 1Meg; R_1206_3216Metric_Pad1.30x1.75mm_HandSolder
R14: 2.7k; R_1206_3216Metric_Pad1.30x1.75mm_HandSolder
R15: 300; R_1206_3216Metric_Pad1.30x1.75mm_HandSolder
R17: 49.9; R_1206_3216Metric_Pad1.30x1.75mm_HandSolder
R18, R22: 2.15k; R_1206_3216Metric_Pad1.30x1.75mm_HandSolder
R19, R23: 19.6k; R_1206_3216Metric_Pad1.30x1.75mm_HandSolder
R20, R24: 1.69k; R_1206_3216Metric_Pad1.30x1.75mm_HandSolder
R21, R25: 16.5k; R_1206_3216Metric_Pad1.30x1.75mm_HandSolder
R26, R30: 1.05M; R_1206_3216Metric_Pad1.30x1.75mm_HandSolder
R27, R28, R31, R32: 100k; R_1206_3216Metric_Pad1.30x1.75mm_HandSolder
R29, R33: 240k; R_1206_3216Metric_Pad1.30x1.75mm_HandSolder
RV1: 100; Potentiometer_Bourns_3296W_Vertical
TP1: TestPoint; TestPoint_Pad_D1.5mm
TP2, TP3, TP4, TP5, TP6, TP7: TestPoint; TestPoint_THTPad_D2.5mm_Drill1.2mm
U1, U2, U3, U4: JFE2140; SOIC-8_3.9x4.9mm_P1.27mm
U5: OPA828; SOIC-8_3.9x4.9mm_P1.27mm
U6: AD8033-ARZ; SOIC-8_3.9x4.9mm_P1.27mm
U7, U8, U9, U13, U16: DG419BDY; SOIC-8_3.9x4.9mm_P1.27mm
U10, U11, U12: ADA4622-1ARZ; SOIC-8_3.9x4.9mm_P1.27mm
U14, U15: OPA191; SOIC-8_3.9x4.9mm_P1.27mm
U17, U19: LT1307CS8; SOIC-8_3.9x4.9mm_P1.27mm
U18, U20: LT3088; SOT-223

Connections:
20k_ENABLE: U11.8 (~DISABLE), U12.8 (~DISABLE)
+12V: C16.1, RV1.2, U5.7 (V+), U6.7 (V+), U10.7 (V+), U11.7 (V+), U12.7 (V+), U14.7 (V+), U15.7 (V+), U18.2 (VO)
+BAT1: C13.1, L1.1, U17.6 (VIN)
+BAT2: C17.1, L2.1, U19.6 (VIN)
-BAT2: C17.2, C18.2, C19.2, C20.2, R1.2, R2.2, R3.2, R4.2, R5.2, R31.2, R33.2, U5.4 (V-), U6.4 (V-), U10.4 (V-), U11.4 (V-), U12.4 (V-), U14.4 (V-), U15.4 (V-), U19.4 (GND)
BOOST_SW: U17.3 (~SHDN), U19.3 (~SHDN)
BUFF_SW: U10.8 (~DISABLE)
FB: C1.2, R11.2, R12.1, U1.8 (G), U2.8 (G), U3.8 (G), U4.8 (G)
GAIN_SW: U7.6
GND: C5.1, C7.1, C9.1, C11.1, C13.2, C14.2, C15.2, C16.2, C20.1, J1.2 (Ext), J2.2 (Ext), J3.1, J4.1, R6.1, R12.2, R13.2, R15.2, R16.2, R27.2, R29.2, U17.4 (GND), U20.2 (VO)
IN: C2.1, K1.12, R13.1, TP1.1, U1.4 (G), U2.4 (G), U3.4 (G), U4.4 (G)
unnamed: C1.1, R11.1, TP2.1, U5.6, U6.3 (+), U7.2
unnamed: C2.2, K1.10
unnamed: C3.1, R14.1, TP3.1, U6.6, U7.8
unnamed: C3.2, R14.2, R15.1, U6.2 (-)
unnamed: C4.1, R16.1, TP4.1, U9.2, U10.3 (+)
unnamed: C4.2, U9.8
unnamed: C5.2, R19.1, U11.3 (+)
unnamed: C6.1, R20.2, U11.2 (-), U11.6
unnamed: C6.2, R18.1, R19.2
unnamed: C7.2, R21.1, U12.3 (+)
unnamed: C8.1, TP6.1, U12.2 (-), U12.6, U13.8
unnamed: C8.2, R20.1, R21.2
unnamed: C9.2, R23.1, U14.3 (+)
unnamed: C10.1, R24.2, U14.2 (-), U14.6
unnamed: C10.2, R22.1, R23.2
unnamed: C11.2, R25.1, U15.3 (+)
unnamed: C12.1, TP7.1, U15.2 (-), U15.6, U16.8
unnamed: C12.2, R24.1, R25.2
unnamed: C14.1, D1.1 (K), R26.1, U18.3 (VI)
unnamed: C15.1, R28.2
unnamed: C18.1, D2.1 (K), R30.1, U20.3 (VI)
unnamed: C19.1, R32.2
unnamed: D1.2 (A), L1.2, U17.5 (SW)
unnamed: D2.2 (A), L2.2, U19.5 (SW)
unnamed: J1.1 (In), K1.7
unnamed: J2.1 (In), R17.1
unnamed: Q1.1 (B), Q2.1 (B), Q3.1 (B), Q4.1 (B), Q5.1 (B)
unnamed: Q1.2 (E), R1.1
unnamed: Q1.3 (C), U1.1 (S), U1.5 (S)
unnamed: Q2.2 (E), R2.1
unnamed: Q2.3 (C), U2.1 (S), U2.5 (S)
unnamed: Q3.2 (E), R3.1
unnamed: Q3.3 (C), U3.1 (S), U3.5 (S)
unnamed: Q4.2 (E), R4.1
unnamed: Q4.3 (C), U4.1 (S), U4.5 (S)
unnamed: Q5.2 (E), R5.1
unnamed: Q5.3 (C), R6.2
unnamed: R7.1, R9.1, RV1.1
unnamed: R7.2, R9.2, U1.2 (D), U2.2 (D), U3.2 (D), U4.2 (D), U5.3 (-)
unnamed: R8.1, R10.1, RV1.3
unnamed: R8.2, R10.2, U1.6 (D), U2.6 (D), U3.6 (D), U4.6 (D), U5.2 (+)
unnamed: R17.2, TP5.1, U10.2 (-), U10.6
unnamed: R18.2, R22.2, U7.1, U8.2
unnamed: R26.2, R27.1, U17.2 (FB)
unnamed: R28.1, U17.1 (Vc)
unnamed: R29.1, U18.1 (SET)
unnamed: R30.2, R31.1, U19.2 (FB)
unnamed: R32.1, U19.1 (Vc)
unnamed: R33.1, U20.1 (SET)
unnamed: U8.1, U9.1
unnamed: U8.8, U13.1, U16.1
OUT_AC_SW: U9.6
WB_SW: U8.6

Notes on the sheet:
AC filter + Buffer + OUT
COMPRARE -470 -680 -1K -1.3K -2K
PSU
Gain stage x101
Low-pass filters
Gain stage x10
IN + AC filter
ADD - DECOUPLING CAPACITORS - LOGIC FOR SWITCHES - SOME LIGHTS

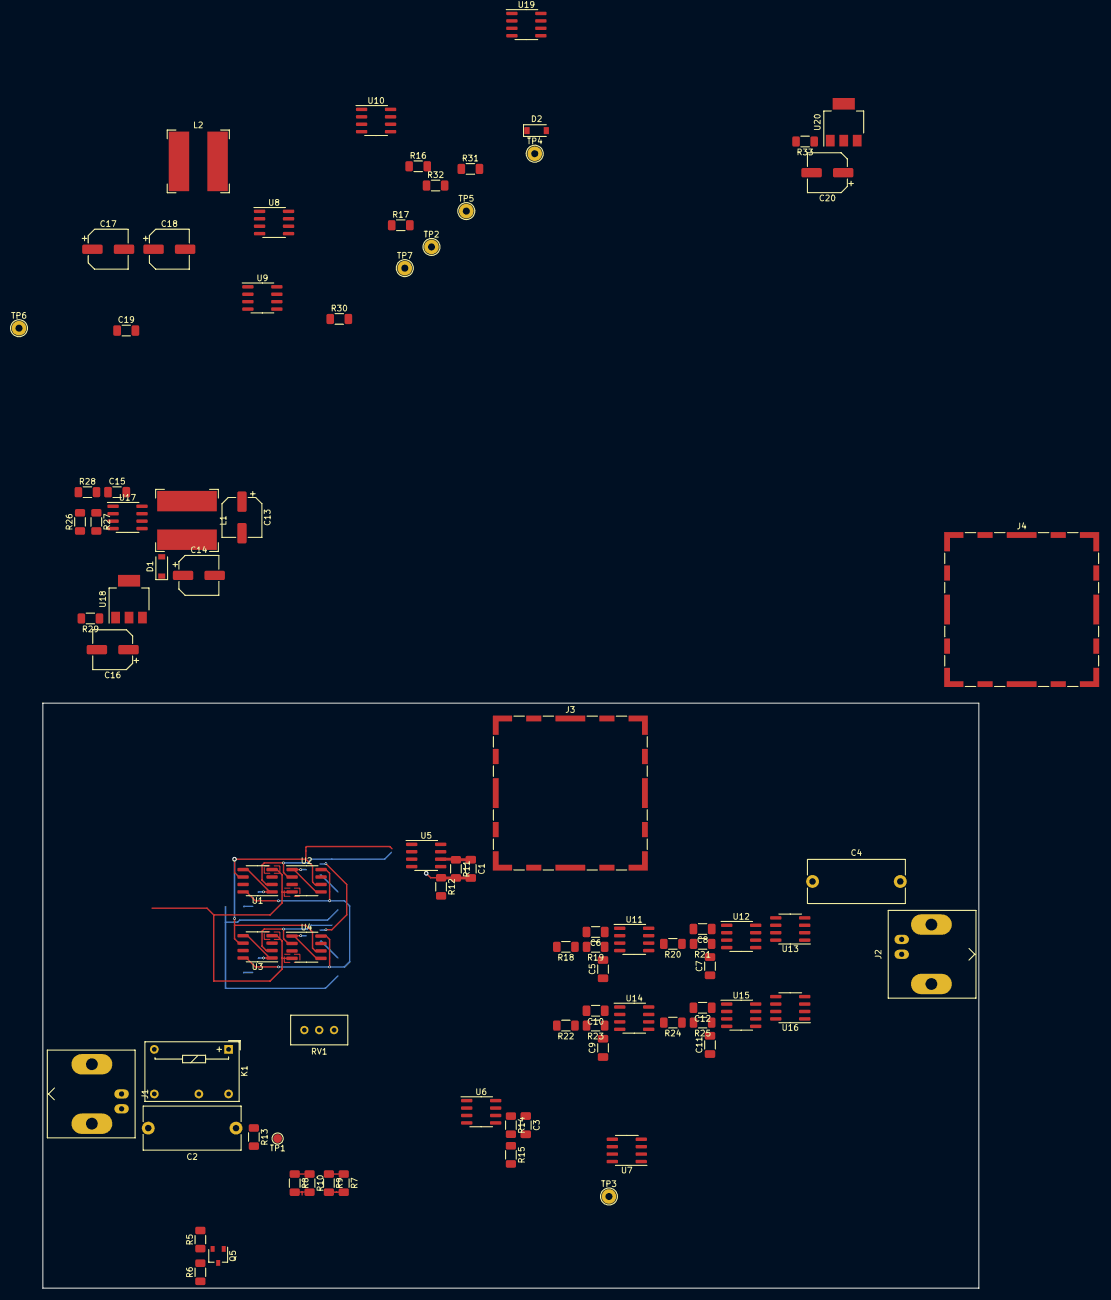
[picture p12: board LNA_v1_BACKUP.kicad_pcb from above]

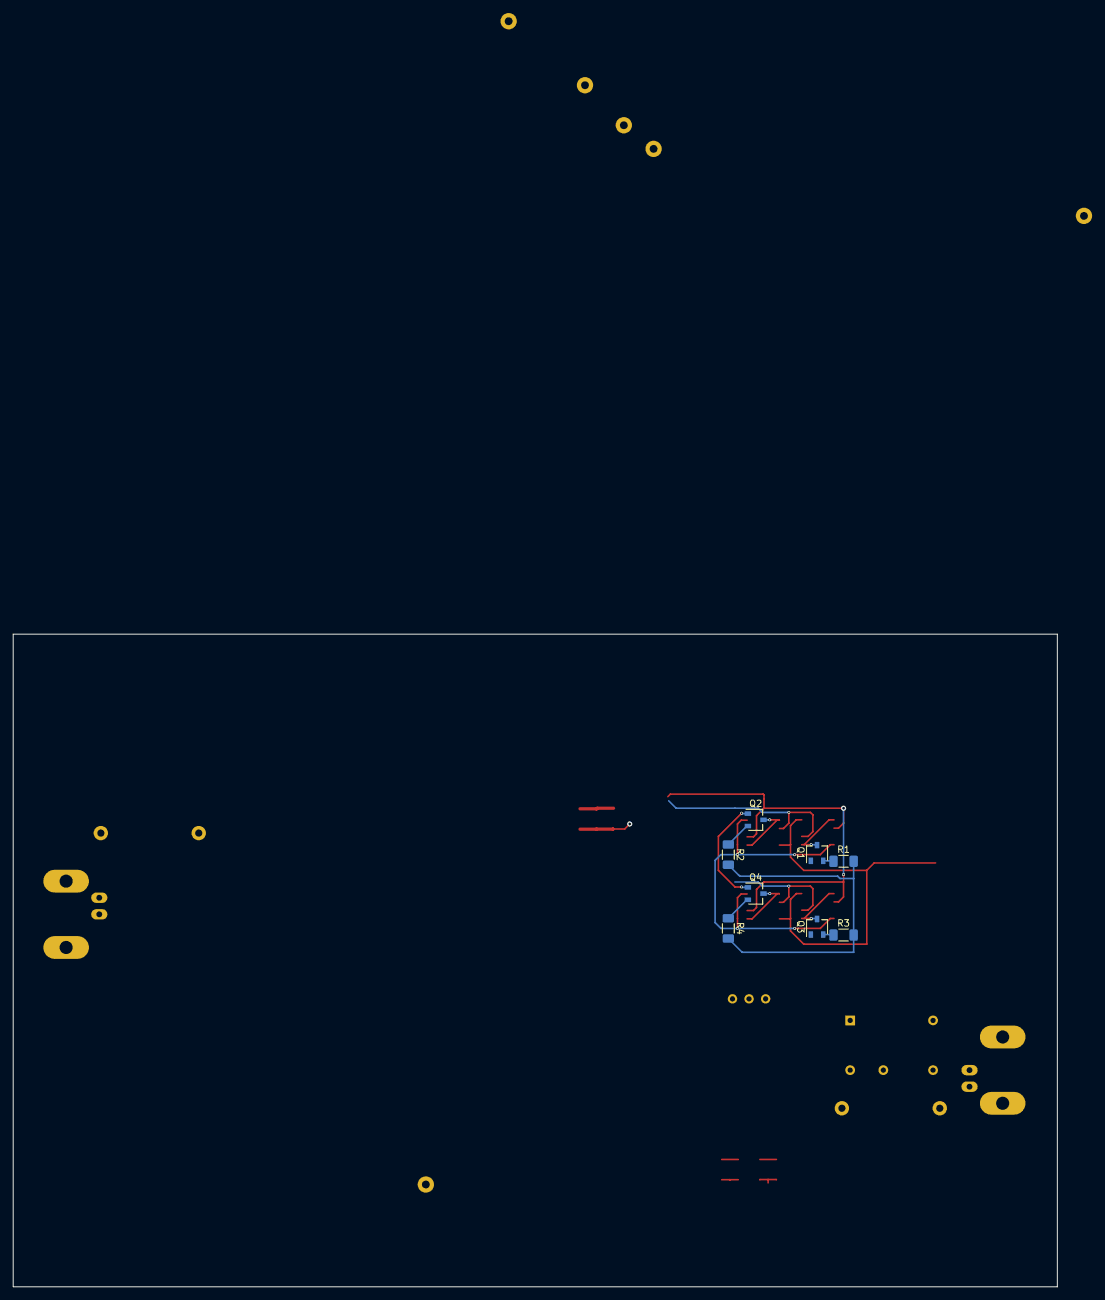
[picture p13: board LNA_v1_BACKUP.kicad_pcb from below]

Board: 2 copper layers, 160.0 x 100.0 mm, 95 parts (8 on the bottom side), 60 nets.
